alexb7396/picoCMP/Kicad picoCMP/BOM.xlsx

Reference | Value | Qty | Manufacturer_Part_Number | Footprint | Placed (YES/NO)
C1 | 22uF | 1 | EMK325B7226KMHP | Capacitor_SMD:C_1210_3225Metric_Pad1.33x2.70mm_HandSolder | YES
C2 | 22uF | 1 | TMK325B7226KM8P | Capacitor_SMD:C_1210_3225Metric_Pad1.33x2.70mm_HandSolder | YES
C14, C15 | 22uF | 2 | C2012X5R1C226K125AC | Capacitor_SMD:C_0805_2012Metric_Pad1.18x1.45mm_HandSolder | YES
C3,C11 | 1uF | 2 | UMK107ABJ105KA8T | Capacitor_SMD:C_0603_1608Metric_Pad1.08x0.95mm_HandSolder | YES
C5 | 1uF | 1 | C1206J105K5RACAUTO | Capacitor_SMD:C_1206_3216Metric_Pad1.33x1.80mm_HandSolder | YES
C10,C13 | 1uF | 2 | C0603X105J4RACTU |  | YES
C6,C16 | 47uF | 2 | C0805C476M9PACTU | Capacitor_SMD:C_0805_2012Metric_Pad1.18x1.45mm_HandSolder | YES
C7 | 56pF | 1 | 06035U560FAT2A | Capacitor_SMD:C_0603_1608Metric_Pad1.08x0.95mm_HandSolder | YES
C8,C17,C18,C19,C20,C21,C22,C24,C25,C26,C27,C28,C29,C30,C31,C32,C33,C34,C35,C36,C37,C38,C39,C40,C41,C42,C43,C44,C45,C46,C47,C48,C49,C50,C51,C52,C53,C54,C55,C56,C57,C58,C59,C60,C61,C62,C63,C64,C65,C66,C67,C68,C69,C70,C71,C72,C73,C74,C75,C76,C77,C78,C79 | 100nF | 63 | C0603C104J4RACTU | Capacitor_SMD:C_0603_1608Metric_Pad1.08x0.95mm_HandSolder | YES
C9 | 2.2nF | 1 | C0603C222F5GACAUTO | Capacitor_SMD:C_0603_1608Metric_Pad1.08x0.95mm_HandSolder | YES
C23 | 470nF | 1 | C0603X474J4RACTU | Capacitor_SMD:C_0603_1608Metric_Pad1.08x0.95mm_HandSolder | YES
C80 | 10uF | 1 | C1608X5R0J106K080AE | Capacitor_SMD:C_0603_1608Metric_Pad1.08x0.95mm_HandSolder | YES
C4,C12 | 1n | 2 | GCM1885C1H102FA16D | Capacitor_SMD:C_0603_1608Metric_Pad1.08x0.95mm_HandSolder | YES
L1 | 3.3uL | 1 | MSD7342-332MLC | SamacSys_Parts:MSD7342332MLC | YES
L2 | 22uL | 1 | MLF1608C220KTA00 | Inductor_SMD:L_0603_1608Metric_Pad1.05x0.95mm_HandSolder | YES
R1,R2 | 4.7K | 2 | CRT0603-FX-4701ELF | Resistor_SMD:R_0603_1608Metric_Pad0.98x0.95mm_HandSolder | YES
R3 | 25.5K | 1 | RT0603FRE0725K5L | Resistor_SMD:R_0603_1608Metric_Pad0.98x0.95mm_HandSolder | YES
R4 | 60.4K | 1 | RT0603FRE0760K4L | Resistor_SMD:R_0603_1608Metric_Pad0.98x0.95mm_HandSolder | YES
R5 | 100K | 1 | MCT06030C1003FP500 | Resistor_SMD:R_0603_1608Metric_Pad0.98x0.95mm_HandSolder | YES
R6 | 45.3K | 1 | RT0603FRE0745K3L | Resistor_SMD:R_0603_1608Metric_Pad0.98x0.95mm_HandSolder | YES
R7 | 124K | 1 | RT0603FRE07124KL | Resistor_SMD:R_0603_1608Metric_Pad0.98x0.95mm_HandSolder | YES
R8 | 6.19K | 1 | RT0603FRE076K19L | Resistor_SMD:R_0603_1608Metric_Pad0.98x0.95mm_HandSolder | YES
R9 | 40.2K | 1 | RT0603FRE0740K2L | Resistor_SMD:R_0603_1608Metric_Pad0.98x0.95mm_HandSolder | YES
R10 | 8.66K | 1 | RT0603FRE078K66L | Resistor_SMD:R_0603_1608Metric_Pad0.98x0.95mm_HandSolder | YES
R11 | 3.3K | 1 | RT0603FRE073K3L | Resistor_SMD:R_0603_1608Metric_Pad0.98x0.95mm_HandSolder | YES
R12 | 118K | 1 | RT0603FRE07118KL | Resistor_SMD:R_0603_1608Metric_Pad0.98x0.95mm_HandSolder | YES
R13 | 46.4K | 1 | RT0603FRE0746K4L | Resistor_SMD:R_0603_1608Metric_Pad0.98x0.95mm_HandSolder | YES
R14 | 210K | 1 | RT0603FRE07210KL | Resistor_SMD:R_0603_1608Metric_Pad0.98x0.95mm_HandSolder | YES
R15,R16,R19,R20,R22,R24,R31,R32,R33,R35,R39,R40,R41,R42,R43,R44,R48,R51,R55,R56,R57,R58,R59,R60,R64,R67,R71,R72,R73,R74,R75,R76,R80,R83,R87,R88,R89,R90,R91,R92,R96,R99,R103,R104,R105,R106,R107,R108,R112,R115,R119,R120,R121,R122,R123,R124,R128,R131,R135,R136,R137,R138,R139,R140,R144 | 50 | 65 | ERJ-3RED49R9V | Resistor_SMD:R_0603_1608Metric_Pad0.98x0.95mm_HandSolder | YES
R17 | 3K | 1 | 560112116128 | Resistor_SMD:R_0603_1608Metric_Pad0.98x0.95mm_HandSolder | YES
R18 | 1K | 1 | 560112116014 | Resistor_SMD:R_0603_1608Metric_Pad0.98x0.95mm_HandSolder | YES
R21,R23,R29,R30,R34,R38,R45,R49,R50,R54,R61,R65,R66,R70,R77,R81,R82,R86,R93,R97,R98,R102,R109,R113,R114,R118,R125,R129,R130,R134,R141,R145 | 4.4K | 32 | CRCW06034K42FKTA | Resistor_SMD:R_0603_1608Metric_Pad0.98x0.95mm_HandSolder | YES
R25,R26,R27,R28,R36,R37,R46,R47,R52,R53,R62,R63,R68,R69,R78,R79,R84,R85,R94,R95,R100,R101,R110,R111,R116,R117,R126,R127,R132,R133,R142,R143 | 10K | 32 | RC0603FR-1010KL | Resistor_SMD:R_0603_1608Metric_Pad0.98x0.95mm_HandSolder | YES
U1 | LTC2627IDE-1_PBF | 1 | LTC2627IDE-1#PBF | LTC2627:DFN-12_DE | YES
U2,U3,U6,U8,U10,U12,U14,U16,U18 | AD8657 | 9 | AD8657ARMZ | SamacSys_Parts:SOP65P490X110-8N | YES
U4,U5,U7,U9,U11,U13,U15,U17 | LMH7322 | 8 | LMH7322SQ/NOPB | SamacSys_Parts:QFN50P400X400X80-25N | YES
IC6 | AD5673RBCPZ-1 | 1 | AD5673RBCPZ-1 | SamacSys_Parts:QFN40P400X400X100-29N-D | YES
IC5 | LT1963AES8-3.3#TRPBF | 1 | LT1963AES8-3.3#TRPBF | SamacSys_Parts:SOIC127P599X175-8N | YES
IC4 | LT3015IMSE-15#PBF | 1 | LT3015IMSE-15#PBF | SamacSys_Parts:SOP65P490X110-13N | YES
IC1,IC3 | LTM8074EY#PBF | 2 | LTM8074EY#PBF | SamacSys_Parts:BGA25C65P5X5_400X400X198 | YES
IC2 | LT3581IDE#PBF | 1 | LT3581IDE#PBF | SamacSys_Parts:SON50P300X400X80-15N-D | YES
J2 | 9185346323 | 1 | 9185346323 | SamacSys_Parts:09185346323 | YES
J4 | 9195346829 | 1 | 9195346829 | Connector:2x17 Connector | YES
J3 | EPL.00.250.NTN | 1 | EPL.00.250.DTN | LEMO-EPA.00.250.DTN:LEMO-EPA.00.250.DTN | YES
J1,J6 | 5-1775444-3 | 2 | 5-1775444-3 | SamacSys_Parts:517754443 | YES
J5 | 1473770000 | 1 | 2383942-2 | SamacSys_Parts:1473770000 | YES
D1 | SSB44-M3_5BT | 1 | SSB44-M3/5BT | SamacSys_Parts:DIOM5436X244N | YES
I2C soscket |  | 1 | 1775441-3 |  | NO
