alexb7396/picoCMP/Kicad picoCMP/A5256.kicad_sch

## KiCad design Kicad picoCMP/A5256.kicad_sch (2025-03-20)

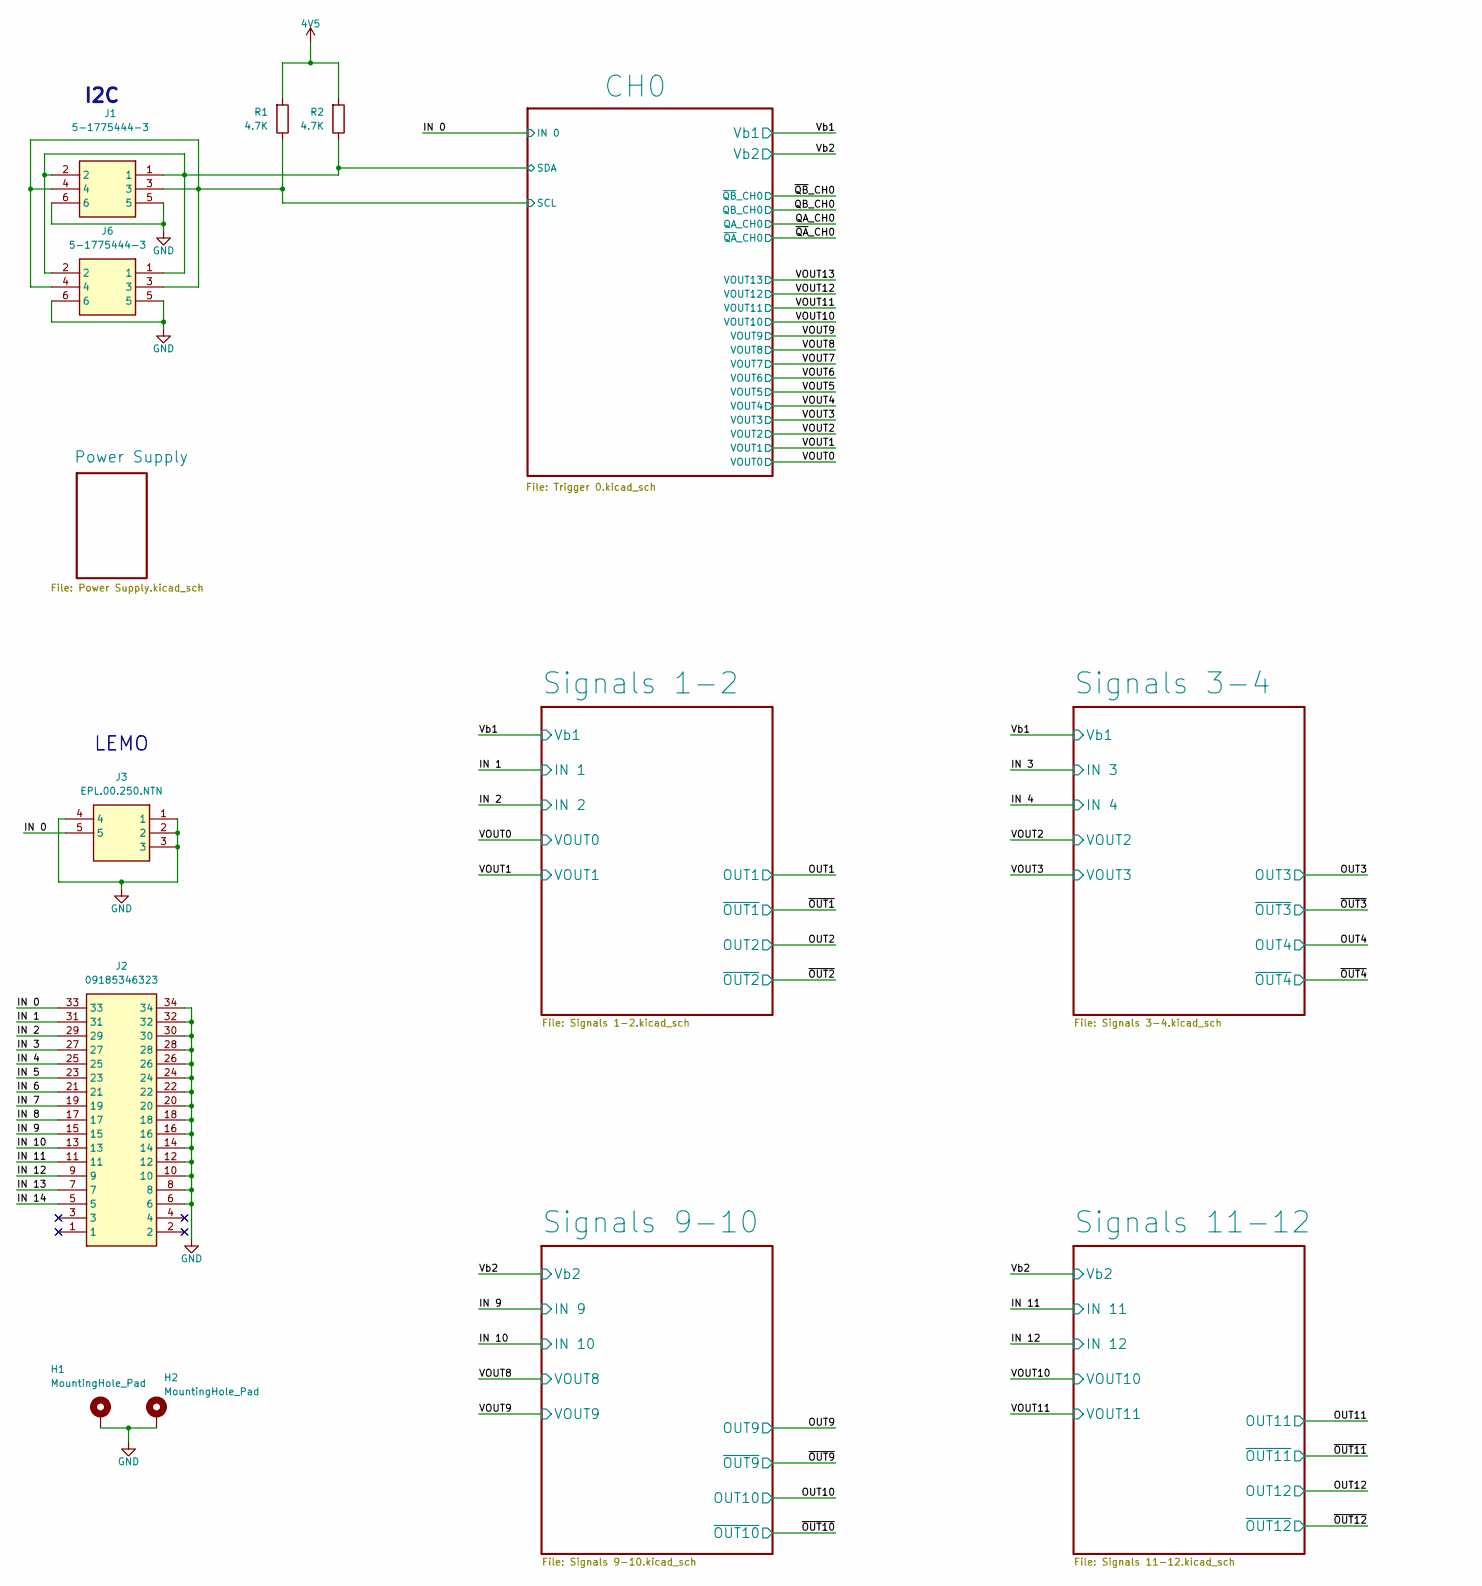
[picture p1: schematic A5256.kicad_sch, part in row 1, column 1]

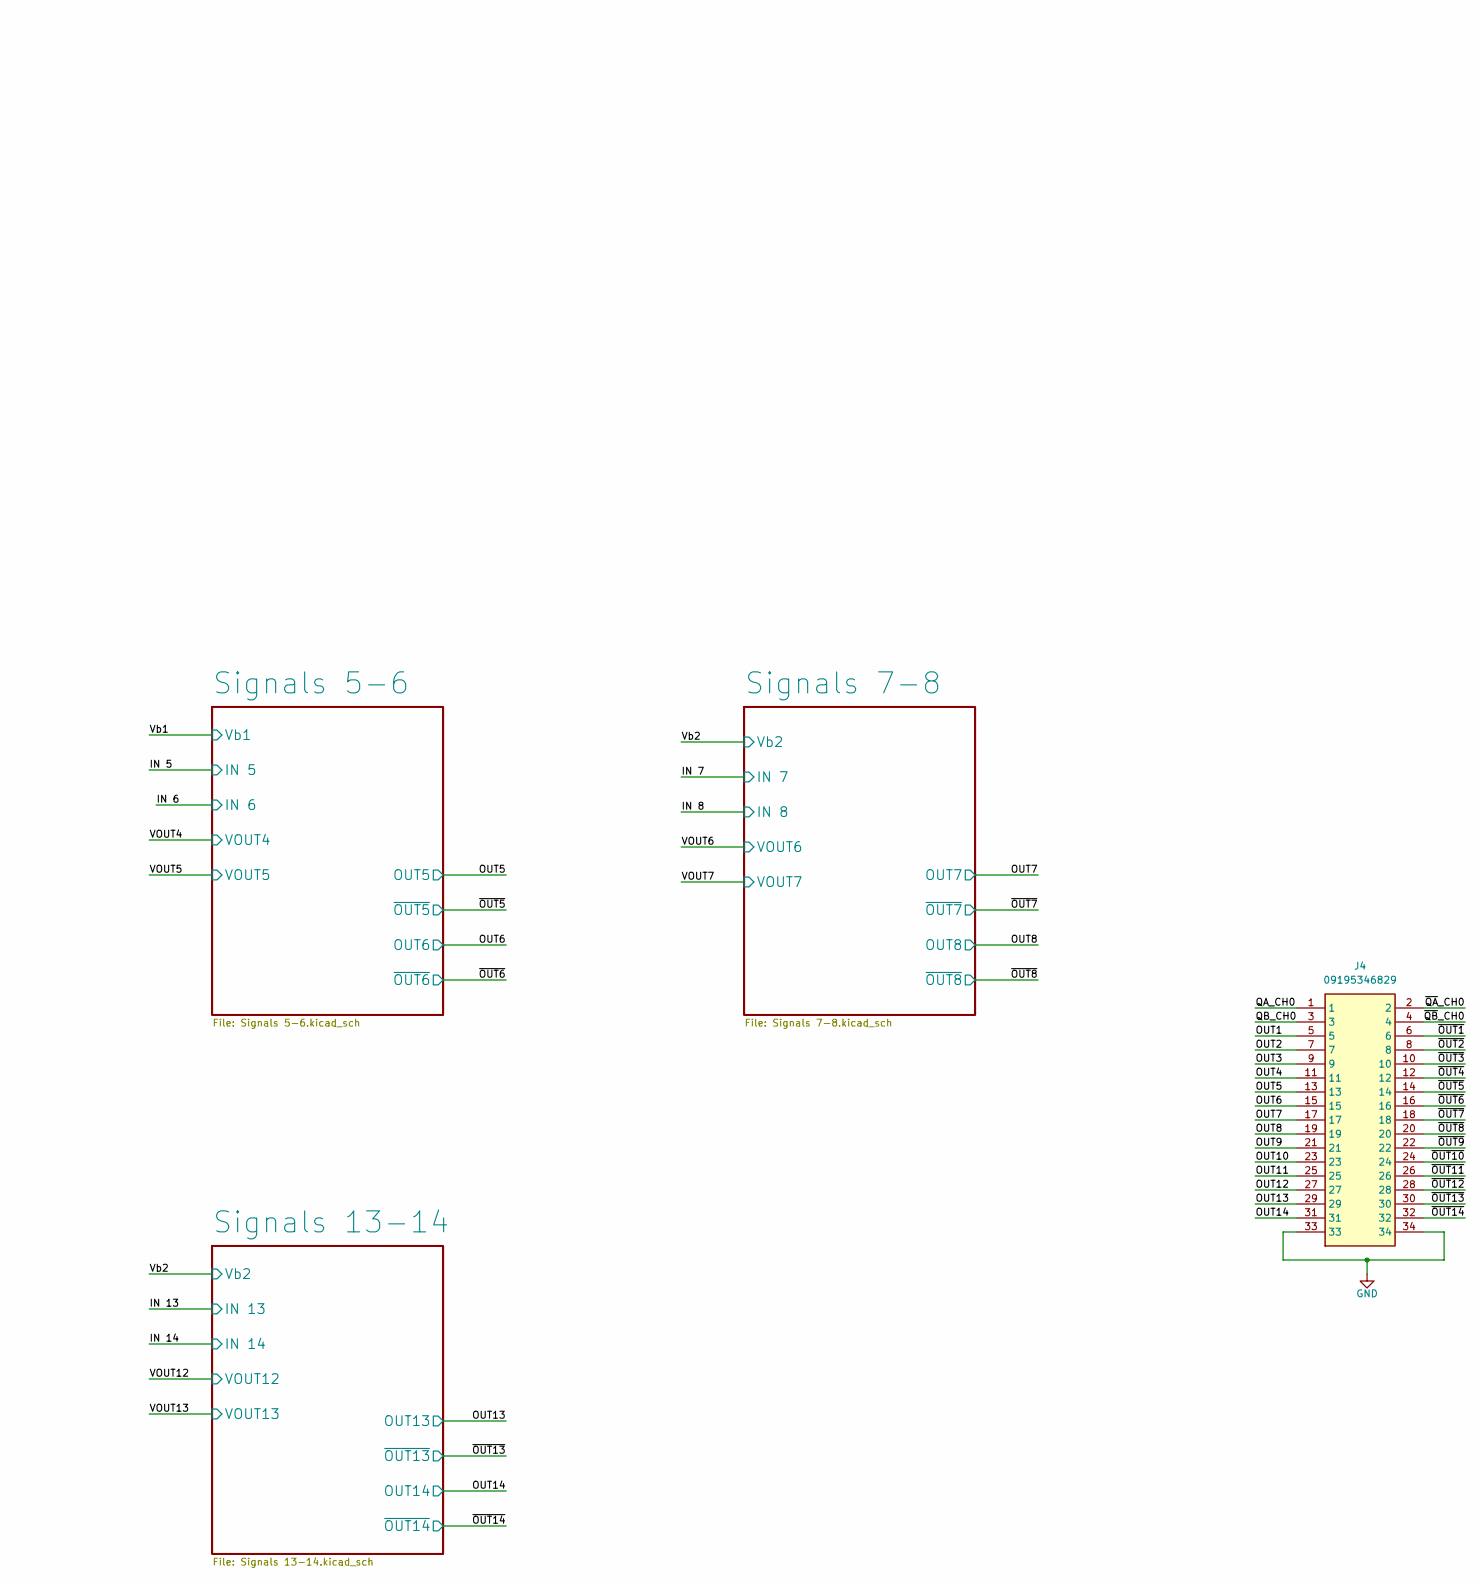
[picture p2: schematic A5256.kicad_sch, part in row 1, column 2]

Parts:
H1, H2: MountingHole_Pad; MountingHole_3mm_Pad_TopBottom
J1, J6: 5-1775444-3; 517754443; Mouser Part Number 571-5-1775444-3
J2: 09185346323; Mouser Part Number 617-09-18-534-6323
J3: EPL.00.250.NTN; LEMO-EPA.00.250.DTN; Mouser Part Number 736-EPL00250NTN
J4: 09195346829; 2x17 Connector; Mouser Part Number 617-09195346829
R1, R2: 4.7K; R_0603_1608Metric_Pad0.98x0.95mm_HandSolder

Connections:
4V5: R1.2, R2.2
GND: H1.1, H2.1, J1.5, J1.6, J2.6, J2.8, J2.10, J2.12, J2.14, J2.16, J2.18, J2.20, J2.22, J2.24, J2.26, J2.28, J2.30, J2.32, J2.34, J3.1, J3.2, J3.3, J3.4, J4.33, J4.34, J6.5, J6.6
IN 0: J2.33, J3.5
IN 1: J2.31
IN 2: J2.29
IN 3: J2.27
IN 4: J2.25
IN 5: J2.23
IN 6: J2.21
IN 7: J2.19
IN 8: J2.17
IN 9: J2.15
IN 10: J2.13
IN 11: J2.11
IN 12: J2.9
IN 13: J2.7
IN 14: J2.5
OUT1: J4.5
OUT2: J4.7
OUT3: J4.9
OUT4: J4.11
OUT5: J4.13
OUT6: J4.15
OUT7: J4.17
OUT8: J4.19
OUT9: J4.21
OUT10: J4.23
OUT11: J4.25
OUT12: J4.27
OUT13: J4.29
OUT14: J4.31
QA_CH0: J4.1
QB_CH0: J4.3
SCL: J1.3, J1.4, J6.3, J6.4, R1.1
SDA: J1.1, J1.2, J6.1, J6.2, R2.1
~OUT1: J4.6
~OUT2: J4.8
~OUT3: J4.10
~OUT4: J4.12
~OUT5: J4.14
~OUT6: J4.16
~OUT7: J4.18
~OUT8: J4.20
~OUT9: J4.22
~OUT10: J4.24
~OUT11: J4.26
~OUT12: J4.28
~OUT13: J4.30
~OUT14: J4.32
~QA_CH0: J4.2
~QB_CH0: J4.4

Notes on the sheet:
I2C
LEMO
