alexb7396/picoCMP/Kicad picoCMP/Power Supply.kicad_sch

## KiCad design Kicad picoCMP/Power Supply.kicad_sch (2025-03-20)

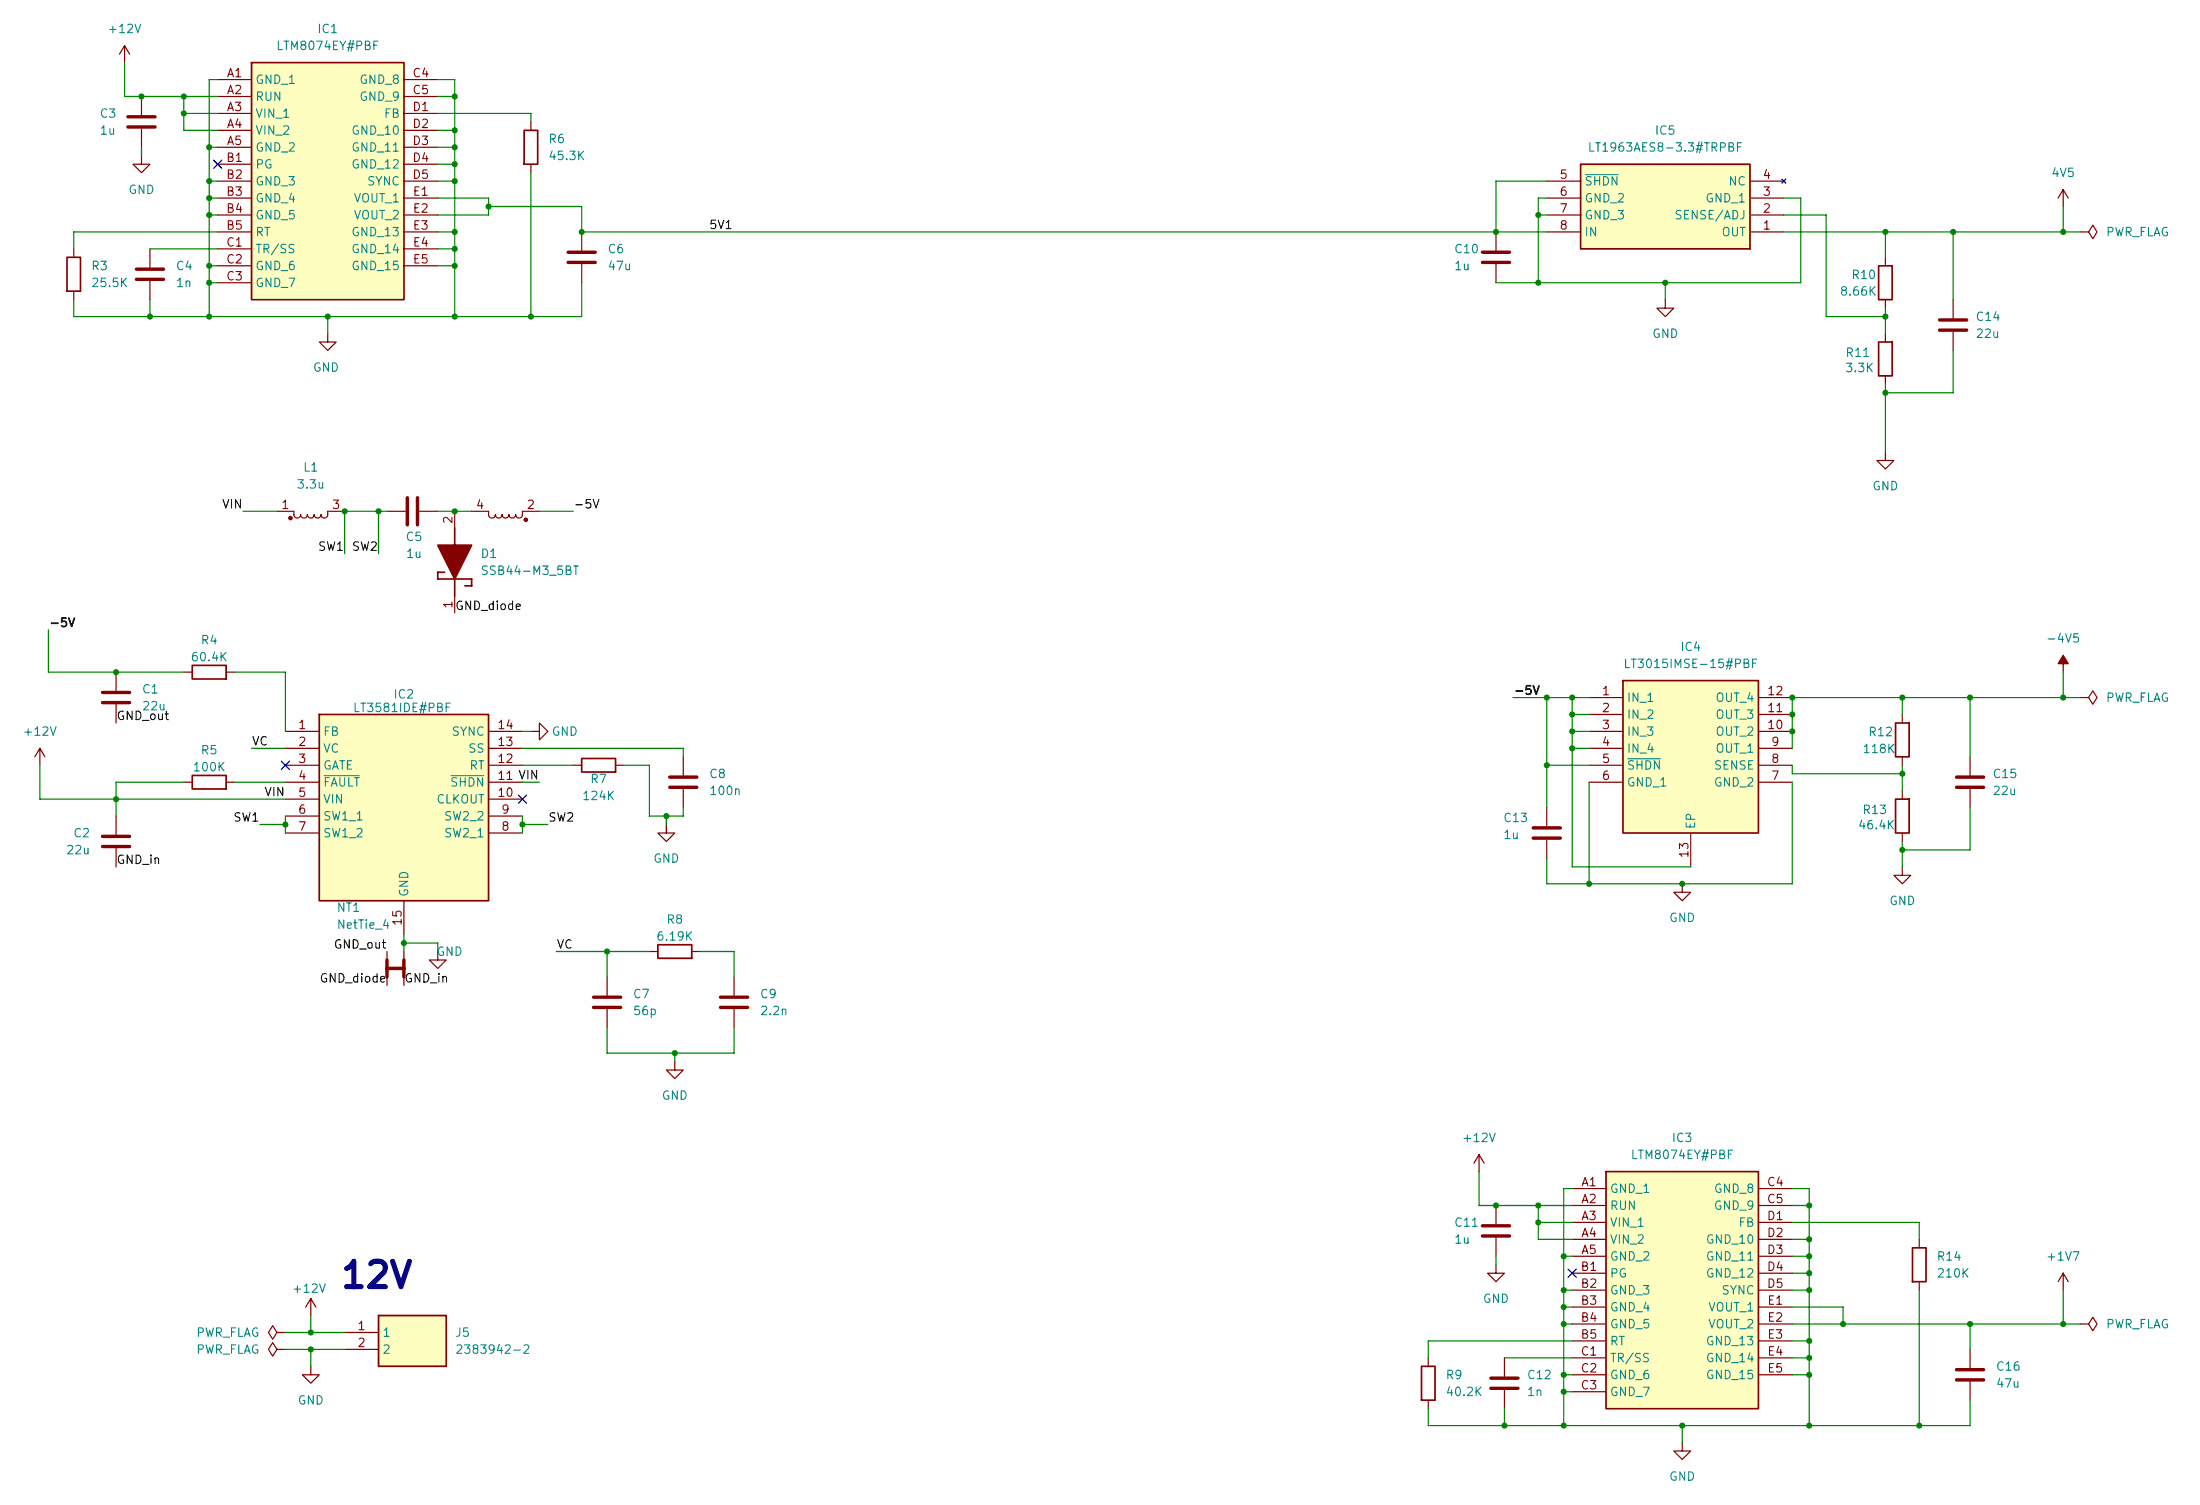
[picture p3: schematic Power Supply.kicad_sch]

Parts:
C1, C2: 22u; C_1210_3225Metric_Pad1.33x2.70mm_HandSolder
C3, C10, C11, C13: 1u; C_0603_1608Metric_Pad1.08x0.95mm_HandSolder
C4, C12: 1n; C_0603_1608Metric_Pad1.08x0.95mm_HandSolder
C5: 1u; C_1206_3216Metric_Pad1.33x1.80mm_HandSolder
C6, C16: 47u; C_0805_2012Metric_Pad1.18x1.45mm_HandSolder
C7: 56p; C_0603_1608Metric_Pad1.08x0.95mm_HandSolder
C8: 100n; C_0603_1608Metric_Pad1.08x0.95mm_HandSolder
C9: 2.2n; C_0603_1608Metric_Pad1.08x0.95mm_HandSolder
C14, C15: 22u; C_0805_2012Metric_Pad1.18x1.45mm_HandSolder
D1: SSB44-M3_5BT; DIOM5436X244N; Mouser Part Number 78-SSB44-M35BT
IC1, IC3: LTM8074EY#PBF; BGA25C65P5X5_400X400X198; Manufacturer_Part_Number LTM8074EY#PBF; Mouser Part Number 584-LTM8074EY#PBF
IC2: LT3581IDE#PBF; SON50P300X400X80-15N-D; Mouser Part Number 584-LT3581IDE#PBF
IC4: LT3015IMSE-15#PBF; SOP65P490X110-13N; Manufacturer_Part_Number LT3015IMSE-15#PBF; Mouser Part Number 584-LT3015IMSE-15PBF
IC5: LT1963AES8-3.3#TRPBF; SOIC127P599X175-8N; Manufacturer_Part_Number LT1963AES8-3.3#TRPBF; Mouser Part Number 584-1963AES8-3.3TPF
J5: 2383942-2; 23839422; Mouser Part Number 571-2383942-2
L1: 3.3u; MSD7342332MLC
NT1: NetTie_4; NetTie-4_SMD_Pad0.5mm
R3: 25.5K; R_0603_1608Metric_Pad0.98x0.95mm_HandSolder
R4: 60.4K; R_0603_1608Metric_Pad0.98x0.95mm_HandSolder
R5: 100K; R_0603_1608Metric_Pad0.98x0.95mm_HandSolder
R6: 45.3K; R_0603_1608Metric_Pad0.98x0.95mm_HandSolder
R7: 124K; R_0603_1608Metric_Pad0.98x0.95mm_HandSolder
R8: 6.19K; R_0603_1608Metric_Pad0.98x0.95mm_HandSolder
R9: 40.2K; R_0603_1608Metric_Pad0.98x0.95mm_HandSolder
R10: 8.66K; R_0603_1608Metric_Pad0.98x0.95mm_HandSolder
R11: 3.3K; R_0603_1608Metric_Pad0.98x0.95mm_HandSolder
R12: 118K; R_0603_1608Metric_Pad0.98x0.95mm_HandSolder
R13: 46.4K; R_0603_1608Metric_Pad0.98x0.95mm_HandSolder
R14: 210K; R_0603_1608Metric_Pad0.98x0.95mm_HandSolder

Connections:
4V5: C14.1, IC5.1 (OUT), R10.2
5V1: C6.1, C10.1, IC1.E1 (VOUT_1), IC1.E2 (VOUT_2), IC5.5 (~SHDN), IC5.8 (IN)
+1V7: C16.1, IC3.E1 (VOUT_1), IC3.E2 (VOUT_2)
+12V: C2.1, C3.1, C11.1, IC1.A2 (RUN), IC1.A3 (VIN_1), IC1.A4 (VIN_2), IC2.5 (VIN), IC2.11 (~SHDN), IC3.A2 (RUN), IC3.A3 (VIN_1), IC3.A4 (VIN_2), J5.1, L1.1, R5.1
-4V5: C15.1, IC4.9 (OUT_1), IC4.10 (OUT_2), IC4.11 (OUT_3), IC4.12 (OUT_4), R12.2
-5V: C1.1, C13.1, IC4.1 (IN_1), IC4.2 (IN_2), IC4.3 (IN_3), IC4.4 (IN_4), IC4.5 (~SHDN), IC4.13 (EP), L1.2, R4.1
GND: C3.2, C4.2, C6.2, C7.1, C8.2, C9.2, C10.2, C11.2, C12.2, C13.2, C14.2, C15.2, C16.2, IC1.A1 (GND_1), IC1.A5 (GND_2), IC1.B2 (GND_3), IC1.B3 (GND_4), IC1.B4 (GND_5), IC1.C2 (GND_6), IC1.C3 (GND_7), IC1.C4 (GND_8), IC1.C5 (GND_9), IC1.D2 (GND_10), IC1.D3 (GND_11), IC1.D4 (GND_12), IC1.D5 (SYNC), IC1.E3 (GND_13), IC1.E4 (GND_14), IC1.E5 (GND_15), IC2.14 (SYNC), IC2.15 (GND), IC3.A1 (GND_1), IC3.A5 (GND_2), IC3.B2 (GND_3), IC3.B3 (GND_4), IC3.B4 (GND_5), IC3.C2 (GND_6), IC3.C3 (GND_7), IC3.C4 (GND_8), IC3.C5 (GND_9), IC3.D2 (GND_10), IC3.D3 (GND_11), IC3.D4 (GND_12), IC3.D5 (SYNC), IC3.E3 (GND_13), IC3.E4 (GND_14), IC3.E5 (GND_15), IC4.6 (GND_1), IC4.7 (GND_2), IC5.3 (GND_1), IC5.6 (GND_2), IC5.7 (GND_3), J5.2, NT1.4, R3.2, R6.2, R7.2, R9.2, R11.1, R13.1, R14.2
GND_diode: D1.1 (K), NT1.1
GND_in: C2.2, NT1.3
GND_out: C1.2, NT1.2
unnamed: C4.1, IC1.C1 (TR/SS)
unnamed: C5.1, D1.2 (A), L1.4
unnamed: C8.1, IC2.13 (SS)
unnamed: C9.1, R8.2
unnamed: C12.1, IC3.C1 (TR/SS)
unnamed: IC1.B5 (RT), R3.1
unnamed: IC1.D1 (FB), R6.1
unnamed: IC2.1 (FB), R4.2
unnamed: IC2.4 (~FAULT), R5.2
unnamed: IC2.12 (RT), R7.1
unnamed: IC3.B5 (RT), R9.1
unnamed: IC3.D1 (FB), R14.1
unnamed: IC4.8 (SENSE), R12.1, R13.2
unnamed: IC5.2 (SENSE/ADJ), R10.1, R11.2
SW1: C5.2, IC2.6 (SW1_1), IC2.7 (SW1_2), IC2.8 (SW2_1), IC2.9 (SW2_2), L1.3
VC: C7.2, IC2.2 (VC), R8.1

Notes on the sheet:
12V
