alexb7396/picoCMP/Kicad picoCMP/Signal Inputs.kicad_sch

## KiCad design Kicad picoCMP/Signal Inputs.kicad_sch (2025-03-20)

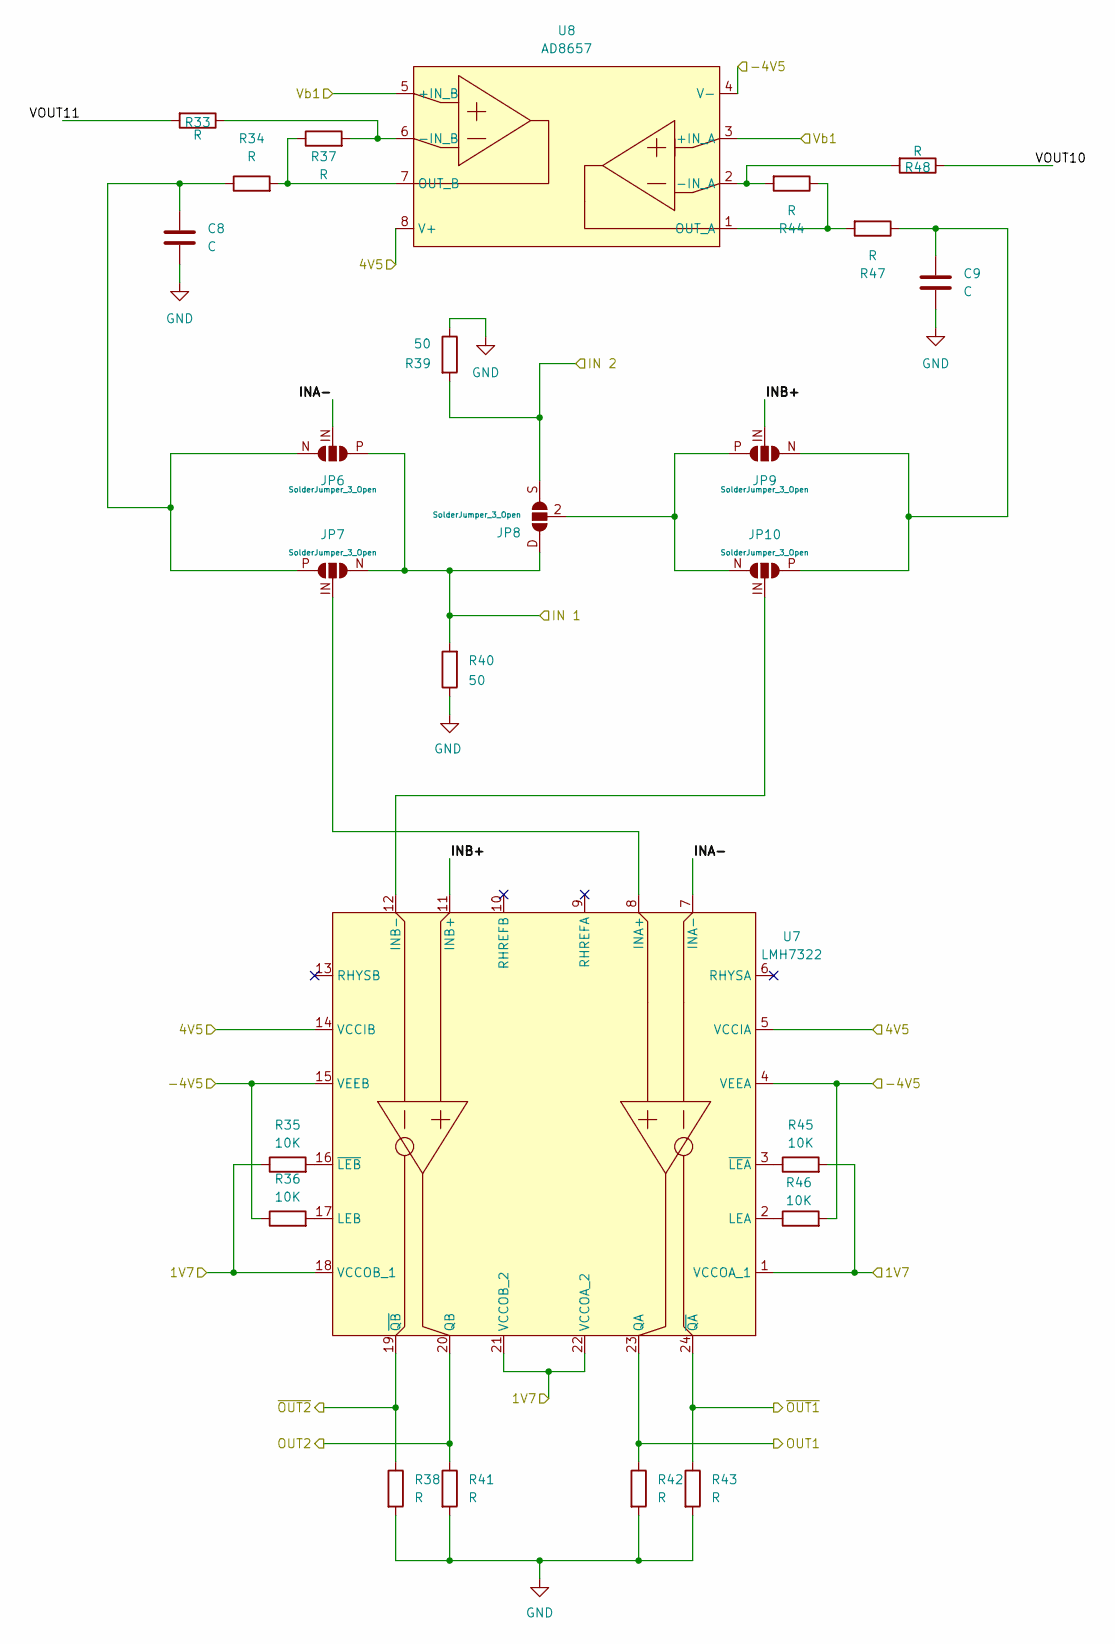
[picture p4: schematic Signal Inputs.kicad_sch]

Parts:
C8, C9: C
JP6, JP7, JP8, JP9, JP10: SolderJumper_3_Open
R33, R34, R37, R38, R41, R42, R43, R44, R47, R48: R
R35, R36, R45, R46: 10K
R39, R40: 50
U7: LMH7322
U8: AD8657; SOP65P490X110-8N

Connections:
1V7: R35.1, R45.2, U7.1 (VCCOA_1), U7.18 (VCCOB_1), U7.21 (VCCOB_2), U7.22 (VCCOA_2)
4V5: U7.5 (VCCIA), U7.14 (VCCIB), U8.8 (V+)
-4V5: R36.1, R46.2, U7.4 (VEEA), U7.15 (VEEB), U8.4 (V-)
GND: C8.2, C9.2, R38.2, R39.1, R40.1, R41.2, R42.2, R43.2
IN 1: JP6.P (A), JP7.N (B), JP8.D (A), R40.2
IN 2: JP8.S (B), R39.2
INA-: JP6.IN (C), U7.7 (INA-)
INB+: JP9.IN (C), U7.11 (INB+)
unnamed: C8.1, JP6.N (B), JP7.P (A), R34.1
unnamed: C9.1, JP9.N (A), JP10.P (B), R47.1
unnamed: JP7.IN (C), U7.8 (INA+)
unnamed: JP10.IN (C), U7.12 (INB-)
unnamed: JP8.2 (IN), JP9.P (B), JP10.N (A)
unnamed: R33.1, R37.2, U8.6 (-IN_B)
unnamed: R34.2, R37.1, U8.7 (OUT_B)
unnamed: R35.2, U7.16 (~LEB)
unnamed: R36.2, U7.17 (LEB)
unnamed: R44.1, R47.2, U8.1 (OUT_A)
unnamed: R44.2, R48.2, U8.2 (-IN_A)
unnamed: R45.1, U7.3 (~LEA)
unnamed: R46.1, U7.2 (LEA)
OUT1: R42.1, U7.23 (QA)
OUT2: R41.1, U7.20 (QB)
VOUT10: R48.1
VOUT11: R33.2
Vb1: U8.3 (+IN_A), U8.5 (+IN_B)
~OUT1: R43.1, U7.24 (~QA)
~OUT2: R38.1, U7.19 (~QB)
