alexb7396/picoCMP/Kicad picoCMP/Signals 1-2.kicad_sch

## KiCad design Kicad picoCMP/Signals 1-2.kicad_sch (2025-03-20)

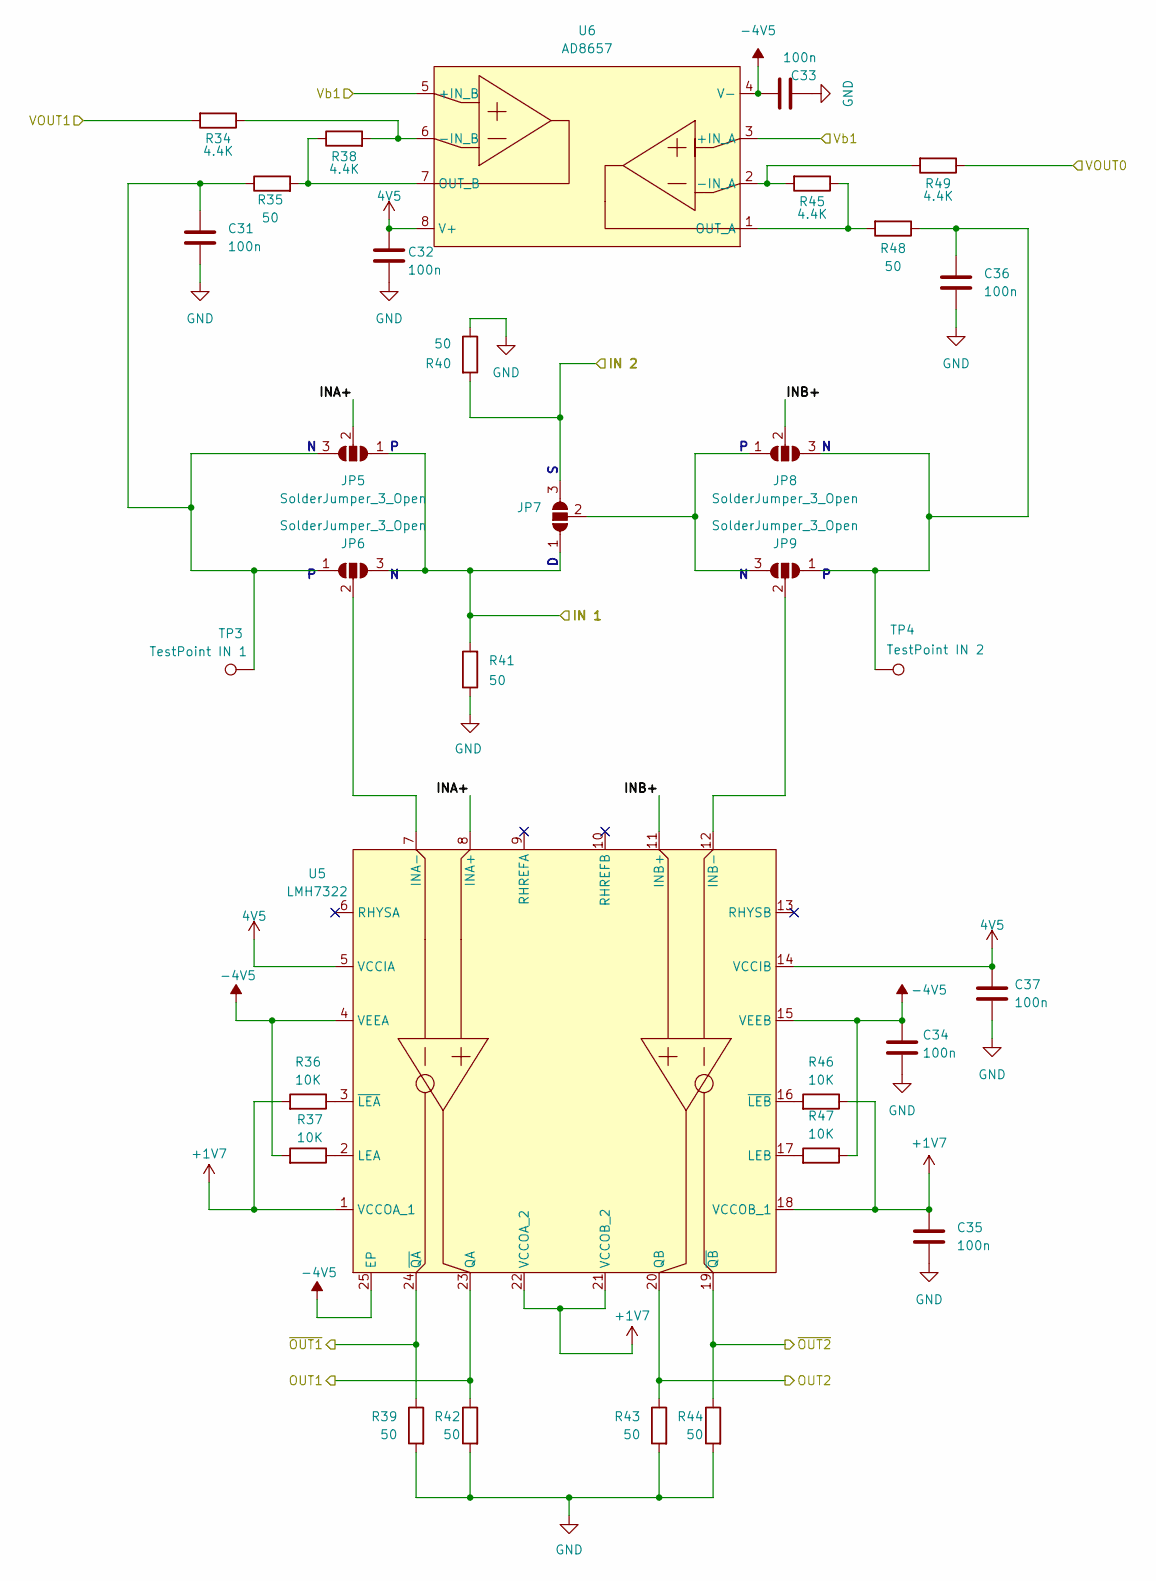
[picture p5: schematic Signals 1-2.kicad_sch]

Parts:
C31, C32, C33, C34, C35, C36, C37: 100n; C_0603_1608Metric_Pad1.08x0.95mm_HandSolder
JP5, JP6, JP7, JP8, JP9: SolderJumper_3_Open; SolderJumper-3_P1.3mm_Open_RoundedPad1.0x1.5mm_NumberLabels
R34, R38, R45, R49: 4.4K; R_0603_1608Metric_Pad0.98x0.95mm_HandSolder
R35, R39, R40, R41, R42, R43, R44, R48: 50; R_0603_1608Metric_Pad0.98x0.95mm_HandSolder
R36, R37, R46, R47: 10K; R_0603_1608Metric_Pad0.98x0.95mm_HandSolder
TP3: TestPoint IN 1; TestPoint_Pad_D1.0mm
TP4: TestPoint IN 2; TestPoint_Pad_D1.0mm
U5: LMH7322; QFN50P400X400X80-25N
U6: AD8657; SOP65P490X110-8N

Connections:
4V5: C32.1, C37.1, U5.5 (VCCIA), U5.14 (VCCIB), U6.8 (V+)
+1V7: C35.1, R36.2, R46.1, U5.1 (VCCOA_1), U5.18 (VCCOB_1), U5.21 (VCCOB_2), U5.22 (VCCOA_2)
-4V5: C33.1, C34.1, R37.2, R47.1, U5.4 (VEEA), U5.15 (VEEB), U5.25 (EP), U6.4 (V-)
GND: C31.2, C32.2, C33.2, C34.2, C35.2, C36.2, C37.2, R39.2, R40.1, R41.1, R42.2, R43.2, R44.2
IN 1: JP5.1 (A), JP6.3 (B), JP7.1 (A), R41.2
IN 2: JP7.3 (B), R40.2
INA+: JP5.2 (C), U5.8 (INA+)
INB+: JP8.2 (C), U5.11 (INB+)
unnamed: C31.1, JP5.3 (B), JP6.1 (A), R35.1, TP3.1
unnamed: C36.1, JP8.3 (B), JP9.1 (A), R48.1, TP4.1
unnamed: JP6.2 (C), U5.7 (INA-)
unnamed: JP7.2 (C), JP8.1 (A), JP9.3 (B)
unnamed: JP9.2 (C), U5.12 (INB-)
unnamed: R34.1, R38.2, U6.6 (-IN_B)
unnamed: R35.2, R38.1, U6.7 (OUT_B)
unnamed: R36.1, U5.3 (~LEA)
unnamed: R37.1, U5.2 (LEA)
unnamed: R45.1, R48.2, U6.1 (OUT_A)
unnamed: R45.2, R49.2, U6.2 (-IN_A)
unnamed: R46.2, U5.16 (~LEB)
unnamed: R47.2, U5.17 (LEB)
OUT1: R42.1, U5.23 (QA)
OUT2: R43.1, U5.20 (QB)
VOUT0: R49.1
VOUT1: R34.2
Vb1: U6.3 (+IN_A), U6.5 (+IN_B)
~OUT1: R39.1, U5.24 (~QA)
~OUT2: R44.1, U5.19 (~QB)
