alexb7396/picoCMP/Kicad picoCMP/Signals 3-4.kicad_sch

## KiCad design Kicad picoCMP/Signals 3-4.kicad_sch (2025-03-20)

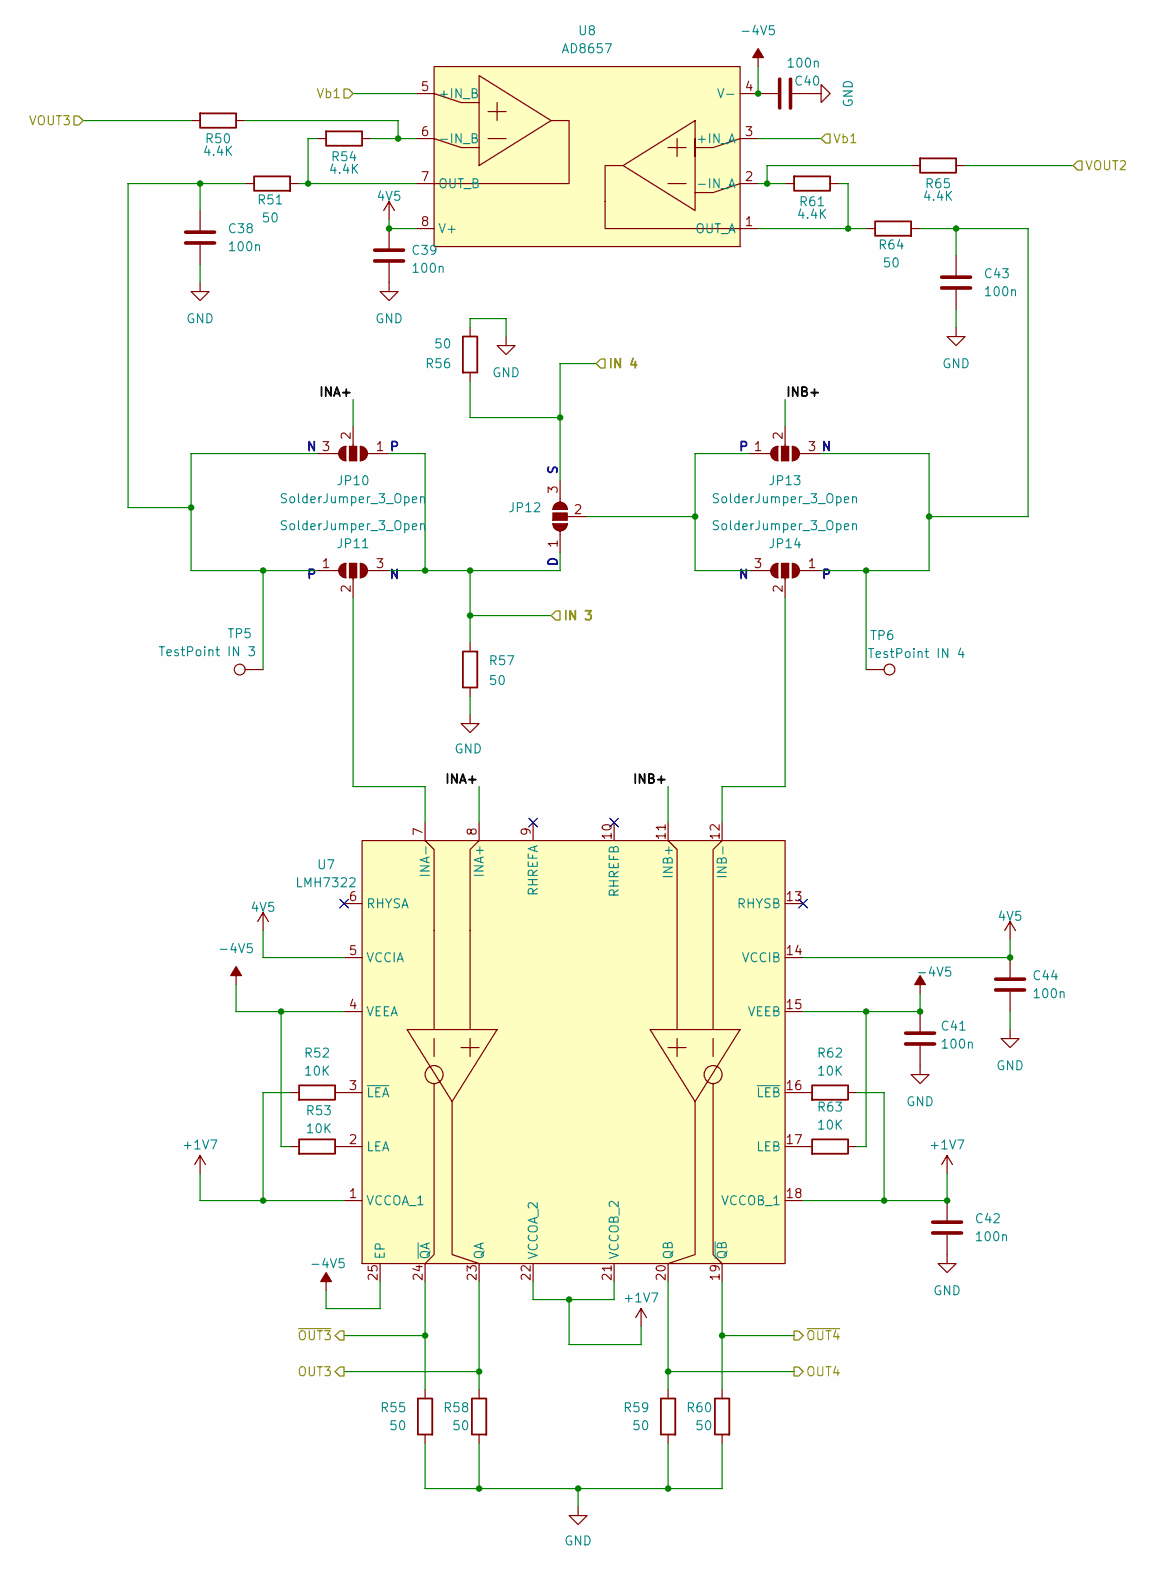
[picture p6: schematic Signals 3-4.kicad_sch]

Parts:
C38, C39, C40, C41, C42, C43, C44: 100n; C_0603_1608Metric_Pad1.08x0.95mm_HandSolder
JP10, JP11, JP12, JP13, JP14: SolderJumper_3_Open; SolderJumper-3_P1.3mm_Open_RoundedPad1.0x1.5mm_NumberLabels
R50, R54, R61, R65: 4.4K; R_0603_1608Metric_Pad0.98x0.95mm_HandSolder
R51, R55, R56, R57, R58, R59, R60, R64: 50; R_0603_1608Metric_Pad0.98x0.95mm_HandSolder
R52, R53, R62, R63: 10K; R_0603_1608Metric_Pad0.98x0.95mm_HandSolder
TP5: TestPoint IN 3; TestPoint_Pad_D1.0mm
TP6: TestPoint IN 4; TestPoint_Pad_D1.0mm
U7: LMH7322; QFN50P400X400X80-25N
U8: AD8657; SOP65P490X110-8N

Connections:
4V5: C39.1, C44.1, U7.5 (VCCIA), U7.14 (VCCIB), U8.8 (V+)
+1V7: C42.1, R52.2, R62.1, U7.1 (VCCOA_1), U7.18 (VCCOB_1), U7.21 (VCCOB_2), U7.22 (VCCOA_2)
-4V5: C40.1, C41.1, R53.2, R63.1, U7.4 (VEEA), U7.15 (VEEB), U7.25 (EP), U8.4 (V-)
GND: C38.2, C39.2, C40.2, C41.2, C42.2, C43.2, C44.2, R55.2, R56.1, R57.1, R58.2, R59.2, R60.2
IN 3: JP10.1 (A), JP11.3 (B), JP12.1 (A), R57.2
IN 4: JP12.3 (B), R56.2
INA+: JP10.2 (C), U7.8 (INA+)
INB+: JP13.2 (C), U7.11 (INB+)
unnamed: C38.1, JP10.3 (B), JP11.1 (A), R51.1, TP5.1
unnamed: C43.1, JP13.3 (B), JP14.1 (A), R64.2, TP6.1
unnamed: JP11.2 (C), U7.7 (INA-)
unnamed: JP12.2 (C), JP13.1 (A), JP14.3 (B)
unnamed: JP14.2 (C), U7.12 (INB-)
unnamed: R50.1, R54.1, U8.6 (-IN_B)
unnamed: R51.2, R54.2, U8.7 (OUT_B)
unnamed: R52.1, U7.3 (~LEA)
unnamed: R53.1, U7.2 (LEA)
unnamed: R61.1, R64.1, U8.1 (OUT_A)
unnamed: R61.2, R65.2, U8.2 (-IN_A)
unnamed: R62.2, U7.16 (~LEB)
unnamed: R63.2, U7.17 (LEB)
OUT3: R58.1, U7.23 (QA)
OUT4: R59.1, U7.20 (QB)
VOUT2: R65.1
VOUT3: R50.2
Vb1: U8.3 (+IN_A), U8.5 (+IN_B)
~OUT3: R55.1, U7.24 (~QA)
~OUT4: R60.1, U7.19 (~QB)
