alexb7396/picoCMP/Kicad picoCMP/Signals 5-6.kicad_sch

## KiCad design Kicad picoCMP/Signals 5-6.kicad_sch (2025-03-20)

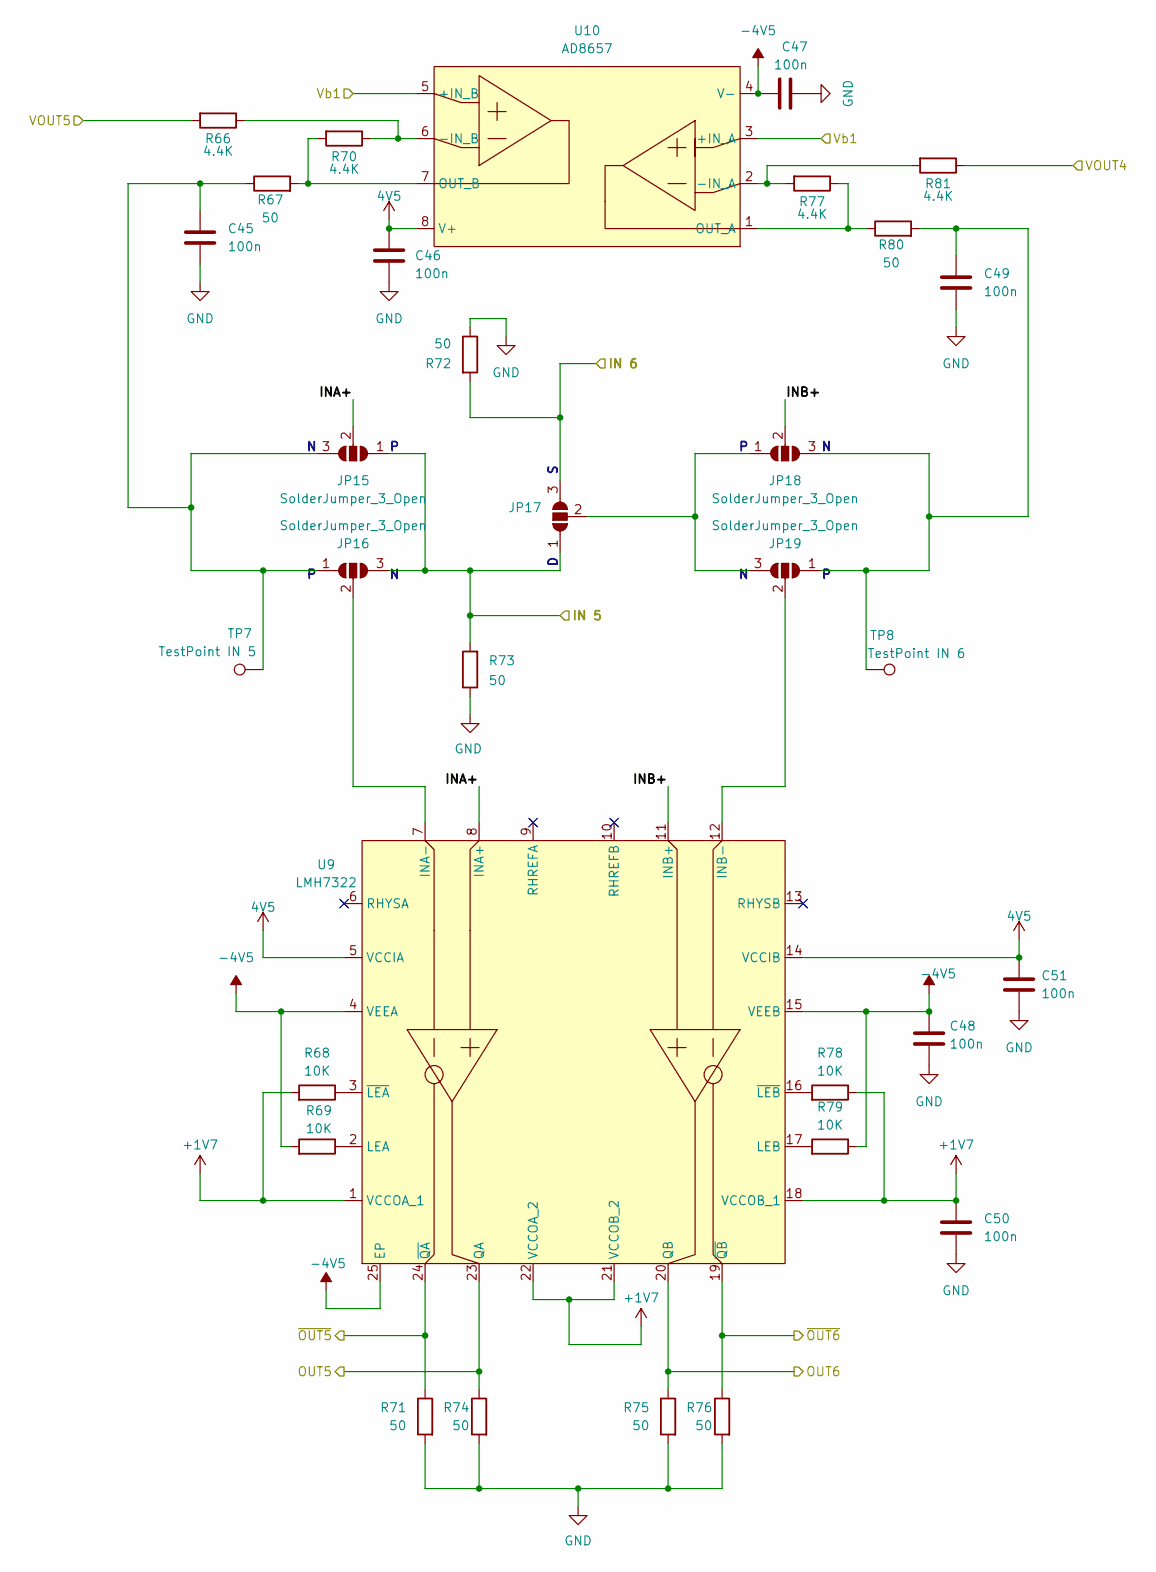
[picture p7: schematic Signals 5-6.kicad_sch]

Parts:
C45, C46, C47, C48, C49, C50, C51: 100n; C_0603_1608Metric_Pad1.08x0.95mm_HandSolder
JP15, JP16, JP17, JP18, JP19: SolderJumper_3_Open; SolderJumper-3_P1.3mm_Open_RoundedPad1.0x1.5mm_NumberLabels
R66, R70, R77, R81: 4.4K; R_0603_1608Metric_Pad0.98x0.95mm_HandSolder
R67, R71, R72, R73, R74, R75, R76, R80: 50; R_0603_1608Metric_Pad0.98x0.95mm_HandSolder
R68, R69, R78, R79: 10K; R_0603_1608Metric_Pad0.98x0.95mm_HandSolder
TP7: TestPoint IN 5; TestPoint_Pad_D1.0mm
TP8: TestPoint IN 6; TestPoint_Pad_D1.0mm
U9: LMH7322; QFN50P400X400X80-25N
U10: AD8657; SOP65P490X110-8N

Connections:
4V5: C46.1, C51.1, U9.5 (VCCIA), U9.14 (VCCIB), U10.8 (V+)
+1V7: C50.1, R68.2, R78.1, U9.1 (VCCOA_1), U9.18 (VCCOB_1), U9.21 (VCCOB_2), U9.22 (VCCOA_2)
-4V5: C47.1, C48.1, R69.2, R79.1, U9.4 (VEEA), U9.15 (VEEB), U9.25 (EP), U10.4 (V-)
GND: C45.2, C46.2, C47.2, C48.2, C49.2, C50.2, C51.2, R71.2, R72.1, R73.1, R74.2, R75.2, R76.2
IN 5: JP15.1 (A), JP16.3 (B), JP17.1 (A), R73.2
IN 6: JP17.3 (B), R72.2
INA+: JP15.2 (C), U9.8 (INA+)
INB+: JP18.2 (C), U9.11 (INB+)
unnamed: C45.1, JP15.3 (B), JP16.1 (A), R67.1, TP7.1
unnamed: C49.1, JP18.3 (B), JP19.1 (A), R80.2, TP8.1
unnamed: JP16.2 (C), U9.7 (INA-)
unnamed: JP17.2 (C), JP18.1 (A), JP19.3 (B)
unnamed: JP19.2 (C), U9.12 (INB-)
unnamed: R66.1, R70.1, U10.6 (-IN_B)
unnamed: R67.2, R70.2, U10.7 (OUT_B)
unnamed: R68.1, U9.3 (~LEA)
unnamed: R69.1, U9.2 (LEA)
unnamed: R77.1, R80.1, U10.1 (OUT_A)
unnamed: R77.2, R81.2, U10.2 (-IN_A)
unnamed: R78.2, U9.16 (~LEB)
unnamed: R79.2, U9.17 (LEB)
OUT5: R74.1, U9.23 (QA)
OUT6: R75.1, U9.20 (QB)
VOUT4: R81.1
VOUT5: R66.2
Vb1: U10.3 (+IN_A), U10.5 (+IN_B)
~OUT5: R71.1, U9.24 (~QA)
~OUT6: R76.1, U9.19 (~QB)
