alexb7396/picoCMP/Kicad picoCMP/Signals 7-8.kicad_sch

## KiCad design Kicad picoCMP/Signals 7-8.kicad_sch (2025-03-20)

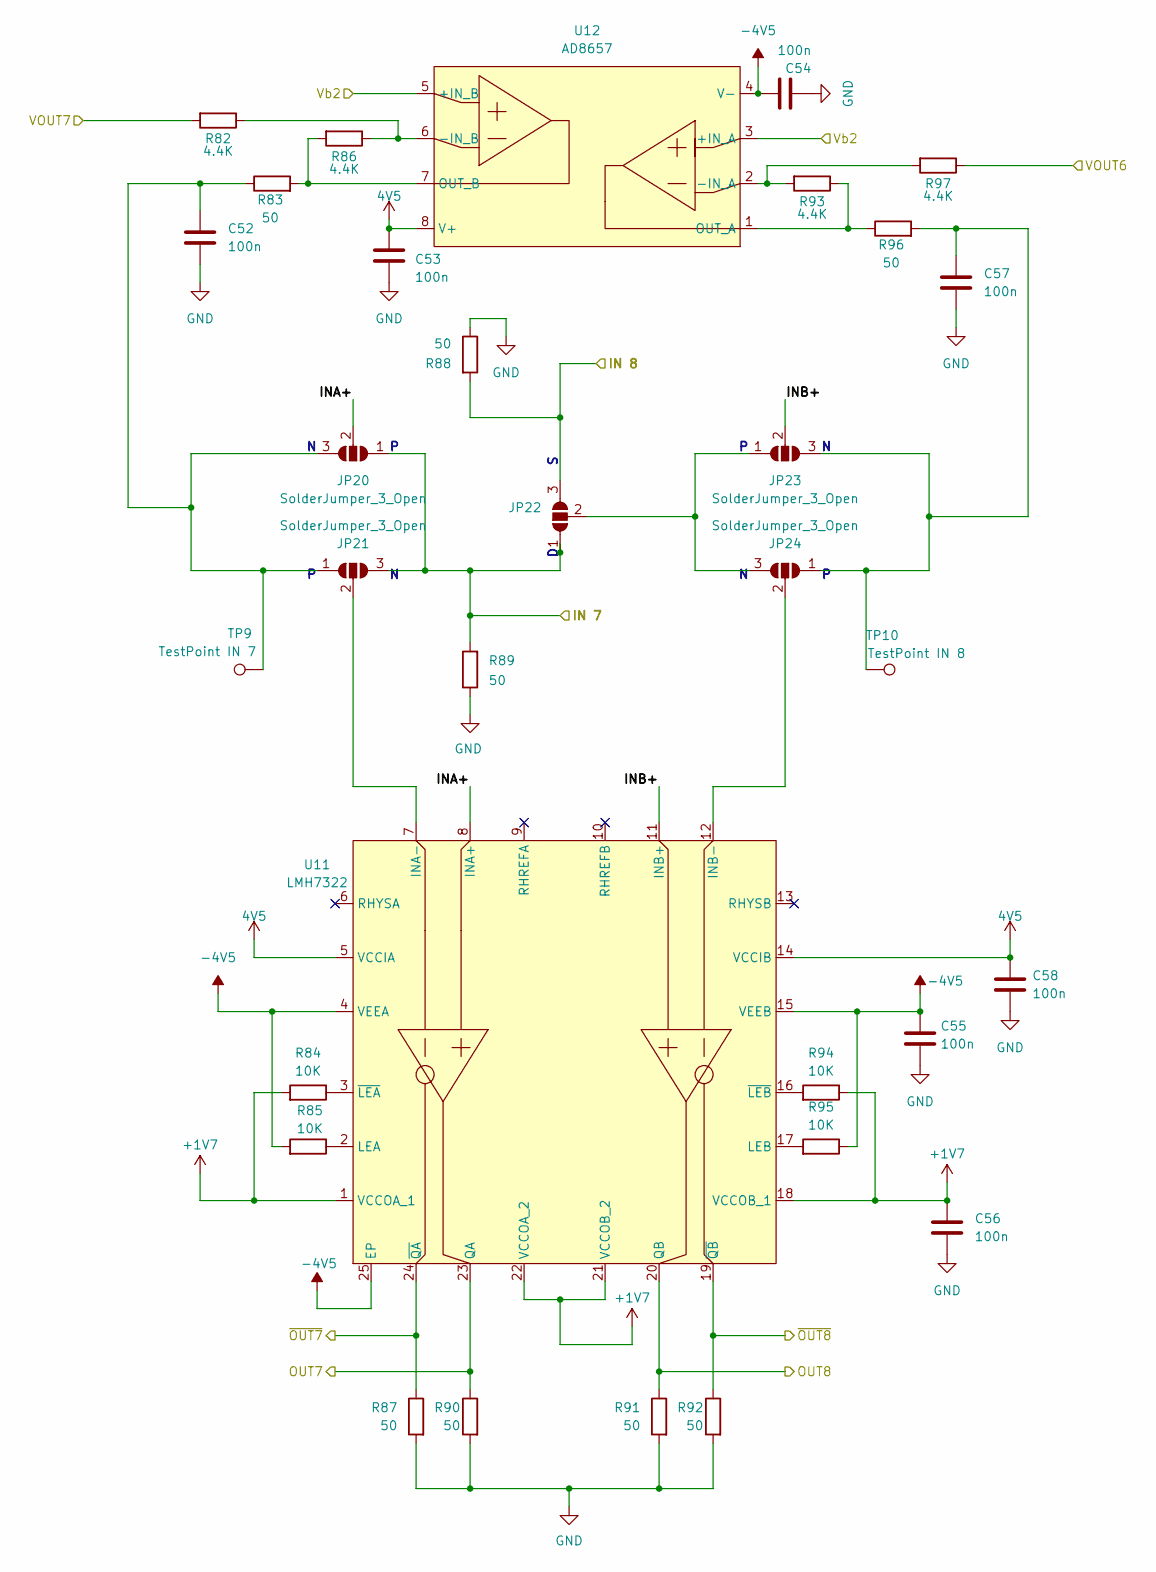
[picture p8: schematic Signals 7-8.kicad_sch]

Parts:
C52, C53, C54, C55, C56, C57, C58: 100n; C_0603_1608Metric_Pad1.08x0.95mm_HandSolder
JP20, JP21, JP22, JP23, JP24: SolderJumper_3_Open; SolderJumper-3_P1.3mm_Open_RoundedPad1.0x1.5mm_NumberLabels
R82, R86, R93, R97: 4.4K; R_0603_1608Metric_Pad0.98x0.95mm_HandSolder
R83, R87, R88, R89, R90, R91, R92, R96: 50; R_0603_1608Metric_Pad0.98x0.95mm_HandSolder
R84, R85, R94, R95: 10K; R_0603_1608Metric_Pad0.98x0.95mm_HandSolder
TP9: TestPoint IN 7; TestPoint_Pad_D1.0mm
TP10: TestPoint IN 8; TestPoint_Pad_D1.0mm
U11: LMH7322; QFN50P400X400X80-25N
U12: AD8657; SOP65P490X110-8N

Connections:
4V5: C53.1, C58.1, U11.5 (VCCIA), U11.14 (VCCIB), U12.8 (V+)
+1V7: C56.1, R84.2, R94.1, U11.1 (VCCOA_1), U11.18 (VCCOB_1), U11.21 (VCCOB_2), U11.22 (VCCOA_2)
-4V5: C54.1, C55.1, R85.2, R95.1, U11.4 (VEEA), U11.15 (VEEB), U11.25 (EP), U12.4 (V-)
GND: C52.2, C53.2, C54.2, C55.2, C56.2, C57.2, C58.2, R87.2, R88.1, R89.1, R90.2, R91.2, R92.2
IN 7: JP20.1 (A), JP21.3 (B), JP22.1 (A), R89.2
IN 8: JP22.3 (B), R88.2
INA+: JP20.2 (C), U11.8 (INA+)
INB+: JP23.2 (C), U11.11 (INB+)
unnamed: C52.1, JP20.3 (B), JP21.1 (A), R83.1, TP9.1
unnamed: C57.1, JP23.3 (B), JP24.1 (A), R96.2, TP10.1
unnamed: JP21.2 (C), U11.7 (INA-)
unnamed: JP22.2 (C), JP23.1 (A), JP24.3 (B)
unnamed: JP24.2 (C), U11.12 (INB-)
unnamed: R82.1, R86.1, U12.6 (-IN_B)
unnamed: R83.2, R86.2, U12.7 (OUT_B)
unnamed: R84.1, U11.3 (~LEA)
unnamed: R85.1, U11.2 (LEA)
unnamed: R93.1, R96.1, U12.1 (OUT_A)
unnamed: R93.2, R97.2, U12.2 (-IN_A)
unnamed: R94.2, U11.16 (~LEB)
unnamed: R95.2, U11.17 (LEB)
OUT7: R90.1, U11.23 (QA)
OUT8: R91.1, U11.20 (QB)
VOUT6: R97.1
VOUT7: R82.2
Vb2: U12.3 (+IN_A), U12.5 (+IN_B)
~OUT7: R87.1, U11.24 (~QA)
~OUT8: R92.1, U11.19 (~QB)
