alexb7396/picoCMP/Kicad picoCMP/Signals 9-10.kicad_sch

## KiCad design Kicad picoCMP/Signals 9-10.kicad_sch (2025-03-20)

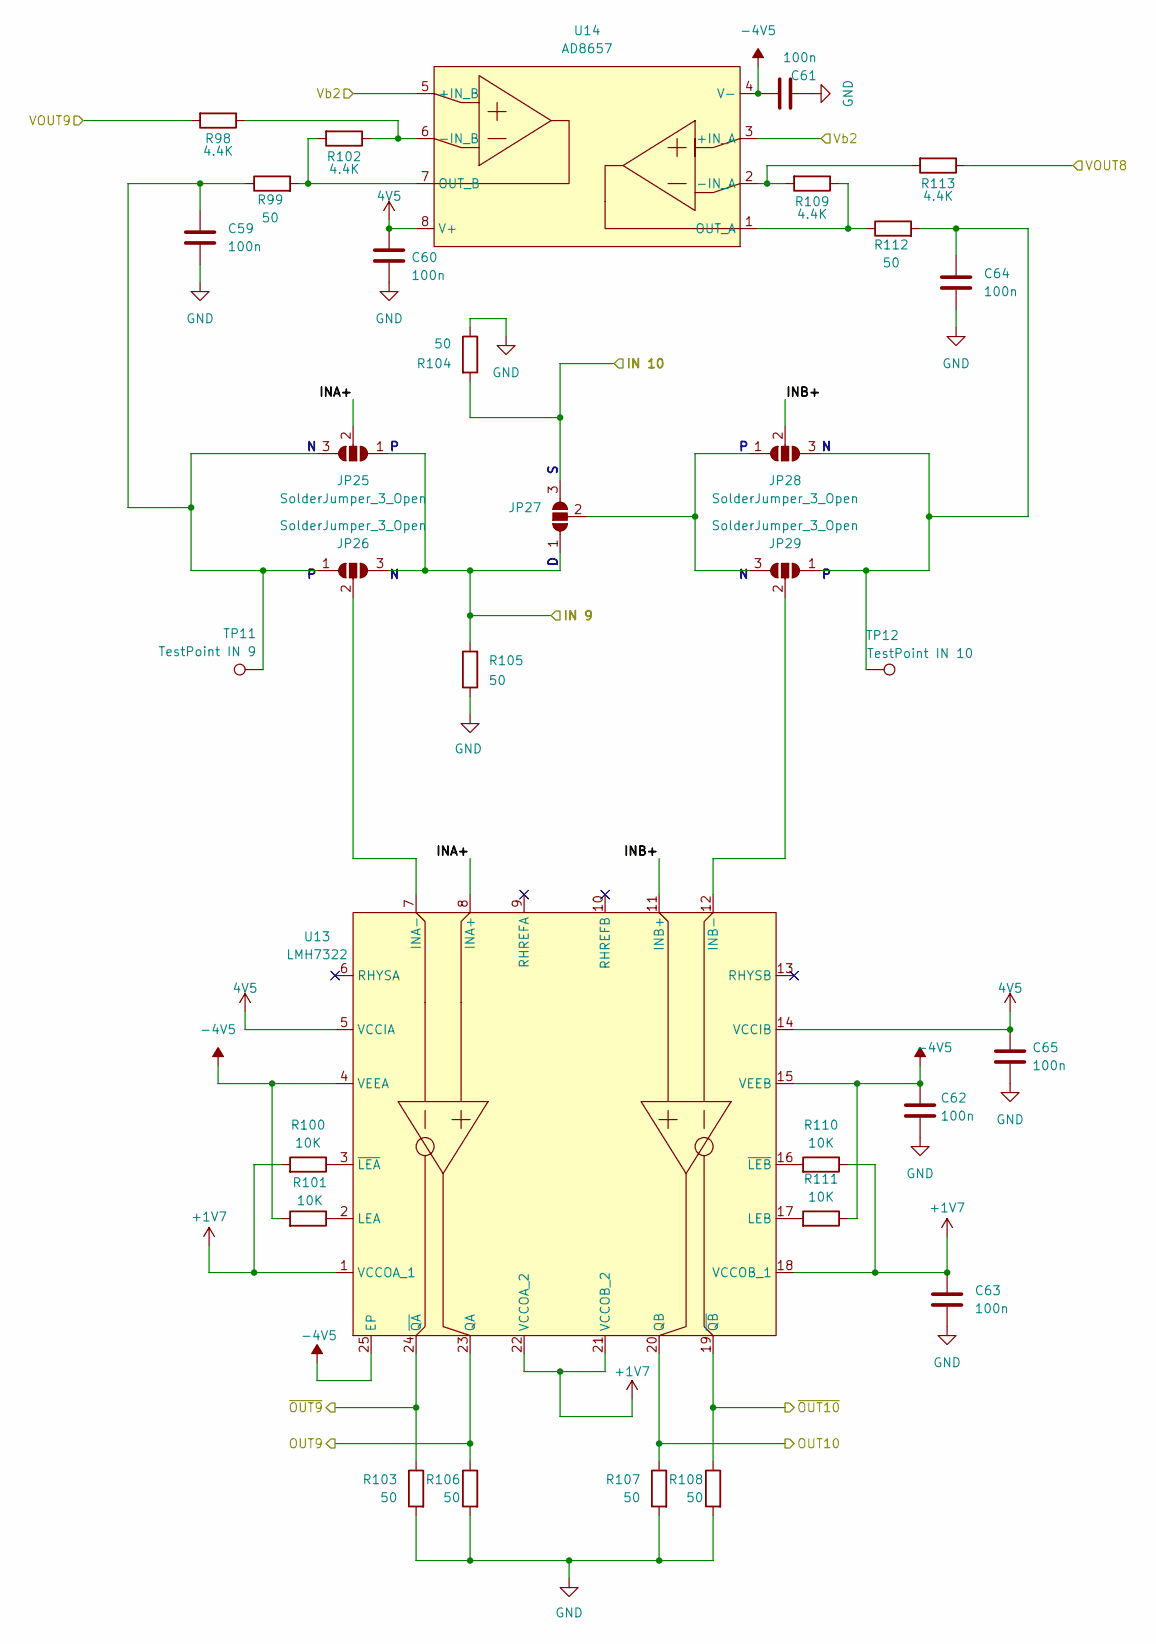
[picture p9: schematic Signals 9-10.kicad_sch]

Parts:
C59, C60, C61, C62, C63, C64, C65: 100n; C_0603_1608Metric_Pad1.08x0.95mm_HandSolder
JP25, JP26, JP27, JP28, JP29: SolderJumper_3_Open; SolderJumper-3_P1.3mm_Open_RoundedPad1.0x1.5mm_NumberLabels
R98, R102, R109, R113: 4.4K; R_0603_1608Metric_Pad0.98x0.95mm_HandSolder
R99, R103, R104, R105, R106, R107, R108, R112: 50; R_0603_1608Metric_Pad0.98x0.95mm_HandSolder
R100, R101, R110, R111: 10K; R_0603_1608Metric_Pad0.98x0.95mm_HandSolder
TP11: TestPoint IN 9; TestPoint_Pad_D1.0mm
TP12: TestPoint IN 10; TestPoint_Pad_D1.0mm
U13: LMH7322; QFN50P400X400X80-25N
U14: AD8657; SOP65P490X110-8N

Connections:
4V5: C60.1, C65.1, U13.5 (VCCIA), U13.14 (VCCIB), U14.8 (V+)
+1V7: C63.1, R100.2, R110.1, U13.1 (VCCOA_1), U13.18 (VCCOB_1), U13.21 (VCCOB_2), U13.22 (VCCOA_2)
-4V5: C61.1, C62.1, R101.2, R111.1, U13.4 (VEEA), U13.15 (VEEB), U13.25 (EP), U14.4 (V-)
GND: C59.2, C60.2, C61.2, C62.2, C63.2, C64.2, C65.2, R103.2, R104.1, R105.1, R106.2, R107.2, R108.2
IN 9: JP25.1 (A), JP26.3 (B), JP27.1 (A), R105.2
IN 10: JP27.3 (B), R104.2
INA+: JP25.2 (C), U13.8 (INA+)
INB+: JP28.2 (C), U13.11 (INB+)
unnamed: C59.1, JP25.3 (B), JP26.1 (A), R99.1, TP11.1
unnamed: C64.1, JP28.3 (B), JP29.1 (A), R112.2, TP12.1
unnamed: JP26.2 (C), U13.7 (INA-)
unnamed: JP27.2 (C), JP28.1 (A), JP29.3 (B)
unnamed: JP29.2 (C), U13.12 (INB-)
unnamed: R100.1, U13.3 (~LEA)
unnamed: R101.1, U13.2 (LEA)
unnamed: R98.1, R102.1, U14.6 (-IN_B)
unnamed: R99.2, R102.2, U14.7 (OUT_B)
unnamed: R109.1, R112.1, U14.1 (OUT_A)
unnamed: R109.2, R113.2, U14.2 (-IN_A)
unnamed: R110.2, U13.16 (~LEB)
unnamed: R111.2, U13.17 (LEB)
OUT9: R106.1, U13.23 (QA)
OUT10: R107.1, U13.20 (QB)
VOUT8: R113.1
VOUT9: R98.2
Vb2: U14.3 (+IN_A), U14.5 (+IN_B)
~OUT9: R103.1, U13.24 (~QA)
~OUT10: R108.1, U13.19 (~QB)
