alexb7396/picoCMP/Kicad picoCMP/Signals 11-12.kicad_sch

## KiCad design Kicad picoCMP/Signals 11-12.kicad_sch (2025-03-20)

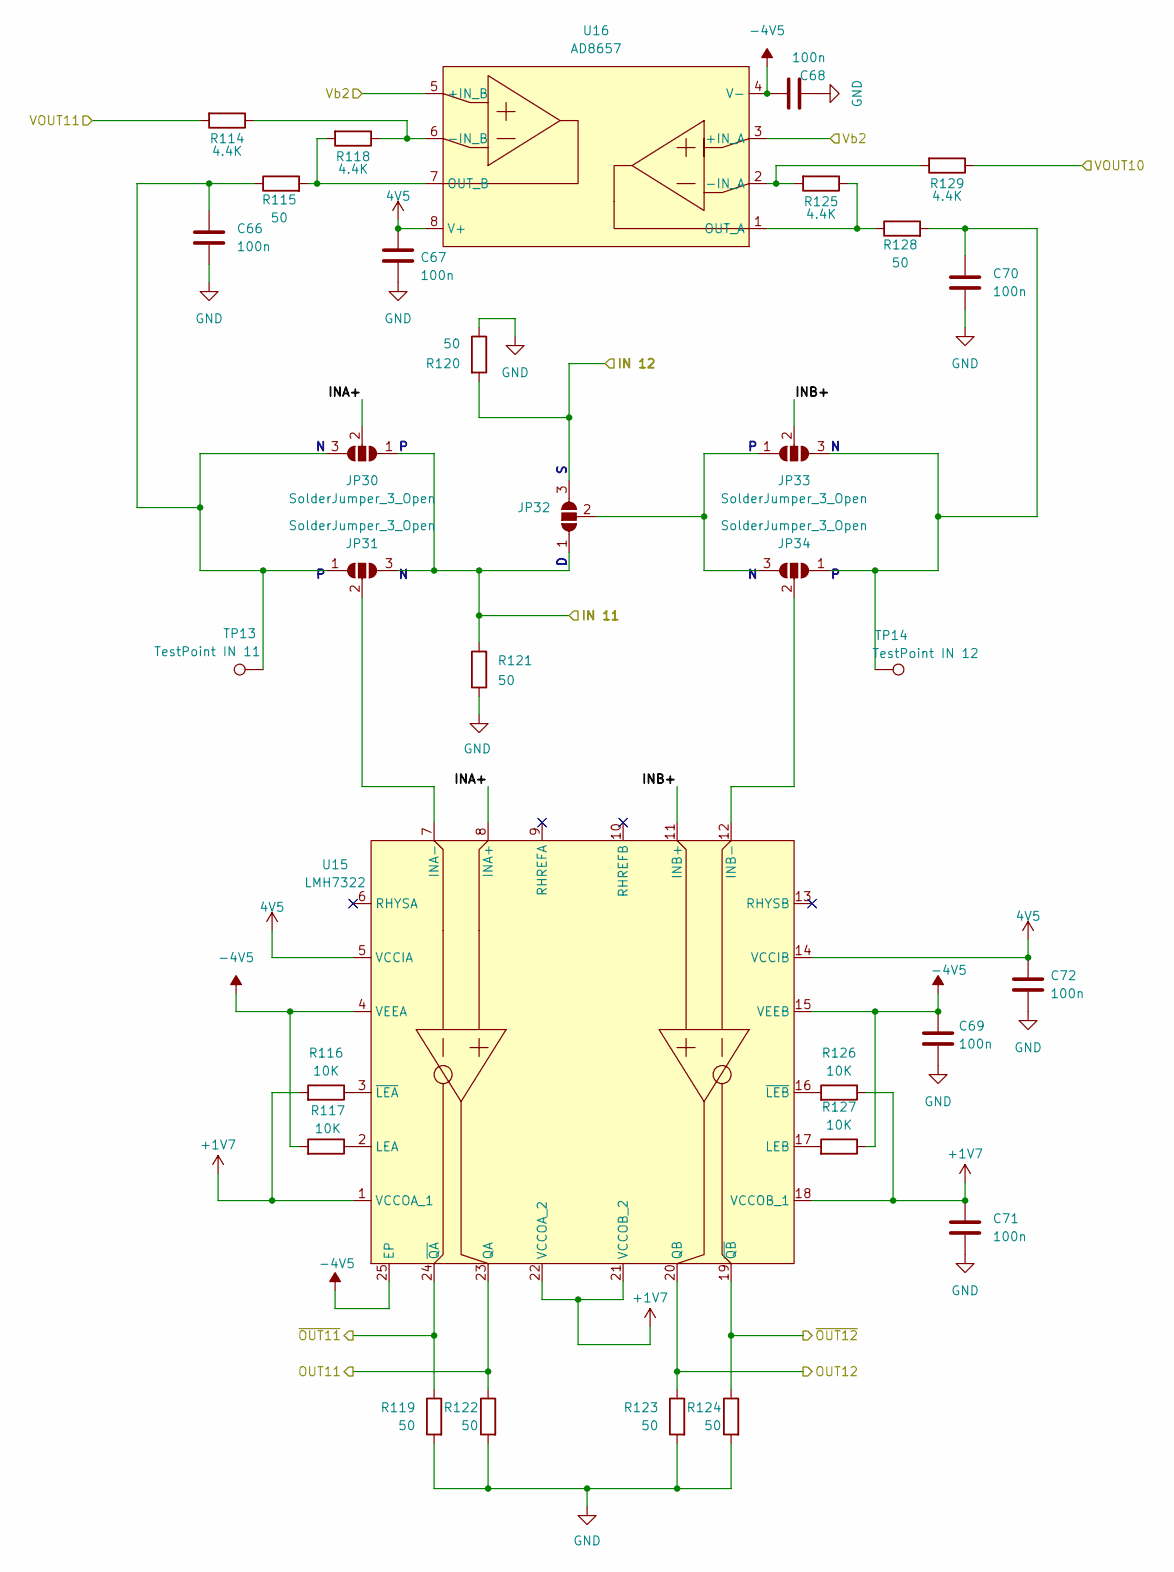
[picture p10: schematic Signals 11-12.kicad_sch]

Parts:
C66, C67, C68, C69, C70, C71, C72: 100n; C_0603_1608Metric_Pad1.08x0.95mm_HandSolder
JP30, JP31, JP32, JP33, JP34: SolderJumper_3_Open; SolderJumper-3_P1.3mm_Open_RoundedPad1.0x1.5mm_NumberLabels
R114, R118, R125, R129: 4.4K; R_0603_1608Metric_Pad0.98x0.95mm_HandSolder
R115, R119, R120, R121, R122, R123, R124, R128: 50; R_0603_1608Metric_Pad0.98x0.95mm_HandSolder
R116, R117, R126, R127: 10K; R_0603_1608Metric_Pad0.98x0.95mm_HandSolder
TP13: TestPoint IN 11; TestPoint_Pad_D1.0mm
TP14: TestPoint IN 12; TestPoint_Pad_D1.0mm
U15: LMH7322; QFN50P400X400X80-25N
U16: AD8657; SOP65P490X110-8N

Connections:
4V5: C67.1, C72.1, U15.5 (VCCIA), U15.14 (VCCIB), U16.8 (V+)
+1V7: C71.1, R116.2, R126.1, U15.1 (VCCOA_1), U15.18 (VCCOB_1), U15.21 (VCCOB_2), U15.22 (VCCOA_2)
-4V5: C68.1, C69.1, R117.2, R127.1, U15.4 (VEEA), U15.15 (VEEB), U15.25 (EP), U16.4 (V-)
GND: C66.2, C67.2, C68.2, C69.2, C70.2, C71.2, C72.2, R119.2, R120.1, R121.1, R122.2, R123.2, R124.2
IN 11: JP30.1 (A), JP31.3 (B), JP32.1 (A), R121.2
IN 12: JP32.3 (B), R120.2
INA+: JP30.2 (C), U15.8 (INA+)
INB+: JP33.2 (C), U15.11 (INB+)
unnamed: C66.1, JP30.3 (B), JP31.1 (A), R115.1, TP13.1
unnamed: C70.1, JP33.3 (B), JP34.1 (A), R128.2, TP14.1
unnamed: JP31.2 (C), U15.7 (INA-)
unnamed: JP32.2 (C), JP33.1 (A), JP34.3 (B)
unnamed: JP34.2 (C), U15.12 (INB-)
unnamed: R114.1, R118.1, U16.6 (-IN_B)
unnamed: R115.2, R118.2, U16.7 (OUT_B)
unnamed: R116.1, U15.3 (~LEA)
unnamed: R117.1, U15.2 (LEA)
unnamed: R125.1, R128.1, U16.1 (OUT_A)
unnamed: R125.2, R129.2, U16.2 (-IN_A)
unnamed: R126.2, U15.16 (~LEB)
unnamed: R127.2, U15.17 (LEB)
OUT11: R122.1, U15.23 (QA)
OUT12: R123.1, U15.20 (QB)
VOUT10: R129.1
VOUT11: R114.2
Vb2: U16.3 (+IN_A), U16.5 (+IN_B)
~OUT11: R119.1, U15.24 (~QA)
~OUT12: R124.1, U15.19 (~QB)
