alexb7396/picoCMP/Kicad picoCMP/Signals 13-14.kicad_sch

## KiCad design Kicad picoCMP/Signals 13-14.kicad_sch (2025-03-20)

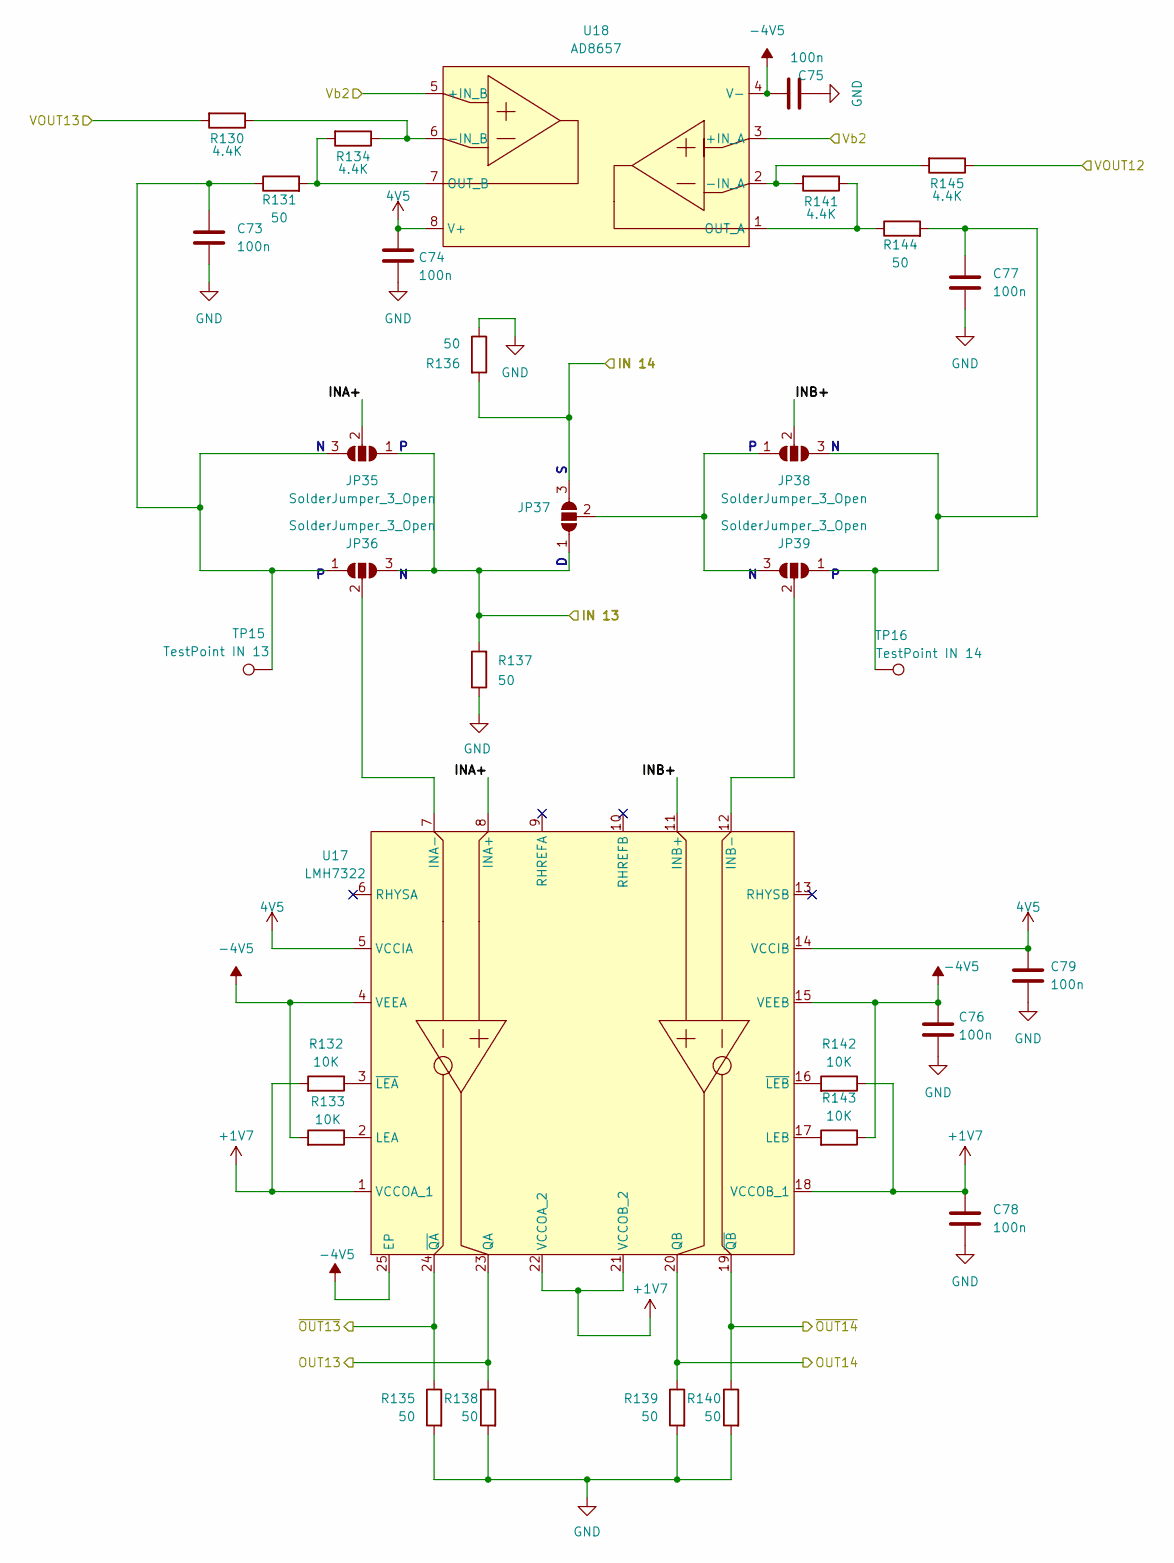
[picture p11: schematic Signals 13-14.kicad_sch]

Parts:
C73, C74, C75, C76, C77, C78, C79: 100n; C_0603_1608Metric_Pad1.08x0.95mm_HandSolder
JP35, JP36, JP37, JP38, JP39: SolderJumper_3_Open; SolderJumper-3_P1.3mm_Open_RoundedPad1.0x1.5mm_NumberLabels
R130, R134, R141, R145: 4.4K; R_0603_1608Metric_Pad0.98x0.95mm_HandSolder
R131, R135, R136, R137, R138, R139, R140, R144: 50; R_0603_1608Metric_Pad0.98x0.95mm_HandSolder
R132, R133, R142, R143: 10K; R_0603_1608Metric_Pad0.98x0.95mm_HandSolder
TP15: TestPoint IN 13; TestPoint_Pad_D1.0mm
TP16: TestPoint IN 14; TestPoint_Pad_D1.0mm
U17: LMH7322; QFN50P400X400X80-25N
U18: AD8657; SOP65P490X110-8N

Connections:
4V5: C74.1, C79.1, U17.5 (VCCIA), U17.14 (VCCIB), U18.8 (V+)
+1V7: C78.1, R132.2, R142.1, U17.1 (VCCOA_1), U17.18 (VCCOB_1), U17.21 (VCCOB_2), U17.22 (VCCOA_2)
-4V5: C75.1, C76.1, R133.2, R143.1, U17.4 (VEEA), U17.15 (VEEB), U17.25 (EP), U18.4 (V-)
GND: C73.2, C74.2, C75.2, C76.2, C77.2, C78.2, C79.2, R135.2, R136.1, R137.1, R138.2, R139.2, R140.2
IN 13: JP35.1 (A), JP36.3 (B), JP37.1 (A), R137.2
IN 14: JP37.3 (B), R136.2
INA+: JP35.2 (C), U17.8 (INA+)
INB+: JP38.2 (C), U17.11 (INB+)
unnamed: C73.1, JP35.3 (B), JP36.1 (A), R131.1, TP15.1
unnamed: C77.1, JP38.3 (B), JP39.1 (A), R144.2, TP16.1
unnamed: JP36.2 (C), U17.7 (INA-)
unnamed: JP37.2 (C), JP38.1 (A), JP39.3 (B)
unnamed: JP39.2 (C), U17.12 (INB-)
unnamed: R130.1, R134.1, U18.6 (-IN_B)
unnamed: R131.2, R134.2, U18.7 (OUT_B)
unnamed: R132.1, U17.3 (~LEA)
unnamed: R133.1, U17.2 (LEA)
unnamed: R141.1, R144.1, U18.1 (OUT_A)
unnamed: R141.2, R145.2, U18.2 (-IN_A)
unnamed: R142.2, U17.16 (~LEB)
unnamed: R143.2, U17.17 (LEB)
OUT13: R138.1, U17.23 (QA)
OUT14: R139.1, U17.20 (QB)
VOUT12: R145.1
VOUT13: R130.2
Vb2: U18.3 (+IN_A), U18.5 (+IN_B)
~OUT13: R135.1, U17.24 (~QA)
~OUT14: R140.1, U17.19 (~QB)
