alexb7396/picoCMP/Kicad picoCMP/Signals 15-16.kicad_sch

## KiCad design Kicad picoCMP/Signals 15-16.kicad_sch (2025-03-20)

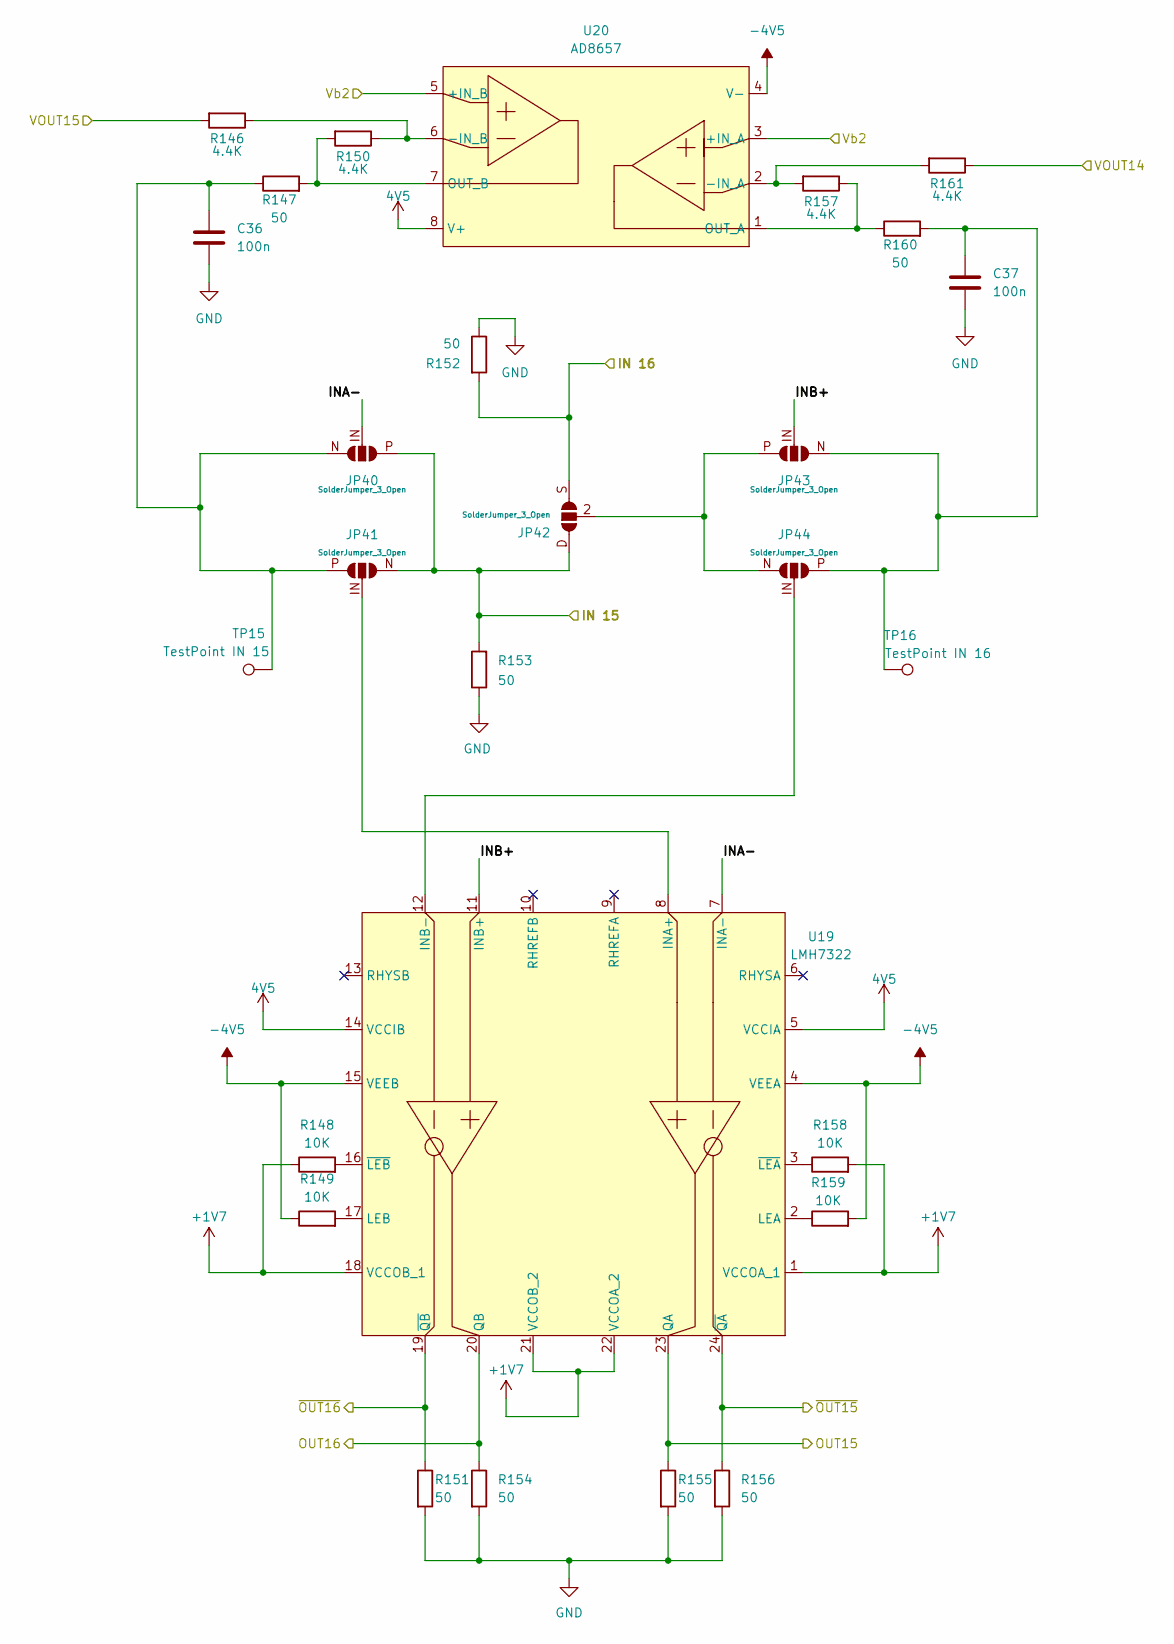
[picture p12: schematic Signals 15-16.kicad_sch]

Parts:
C36, C37: 100n
JP40, JP41, JP42, JP43, JP44: SolderJumper_3_Open
R146, R150, R157, R161: 4.4K
R147, R151, R152, R153, R154, R155, R156, R160: 50
R148, R149, R158, R159: 10K
TP15: TestPoint IN 15
TP16: TestPoint IN 16
U19: LMH7322; QFN50P400X400X80-25N
U20: AD8657; SOP65P490X110-8N

Connections:
4V5: U19.5 (VCCIA), U19.14 (VCCIB), U20.8 (V+)
+1V7: R148.1, R158.2, U19.1 (VCCOA_1), U19.18 (VCCOB_1), U19.21 (VCCOB_2), U19.22 (VCCOA_2)
-4V5: R149.1, R159.2, U19.4 (VEEA), U19.15 (VEEB), U20.4 (V-)
GND: C36.2, C37.2, R151.2, R152.1, R153.1, R154.2, R155.2, R156.2
IN 15: JP40.P (A), JP41.N (B), JP42.D (A), R153.2
IN 16: JP42.S (B), R152.2
INA-: JP40.IN (C), U19.7 (INA-)
INB+: JP43.IN (C), U19.11 (INB+)
unnamed: C36.1, JP40.N (B), JP41.P (A), R147.1, TP15.1
unnamed: C37.1, JP43.N (A), JP44.P (B), R160.2, TP16.1
unnamed: JP41.IN (C), U19.8 (INA+)
unnamed: JP42.2 (IN), JP43.P (B), JP44.N (A)
unnamed: JP44.IN (C), U19.12 (INB-)
unnamed: R146.1, R150.1, U20.6 (-IN_B)
unnamed: R147.2, R150.2, U20.7 (OUT_B)
unnamed: R148.2, U19.16 (~LEB)
unnamed: R149.2, U19.17 (LEB)
unnamed: R157.1, R160.1, U20.1 (OUT_A)
unnamed: R157.2, R161.2, U20.2 (-IN_A)
unnamed: R158.1, U19.3 (~LEA)
unnamed: R159.1, U19.2 (LEA)
OUT15: R155.1, U19.23 (QA)
OUT16: R154.1, U19.20 (QB)
VOUT14: R161.1
VOUT15: R146.2
Vb2: U20.3 (+IN_A), U20.5 (+IN_B)
~OUT15: R156.1, U19.24 (~QA)
~OUT16: R151.1, U19.19 (~QB)
