alexb7396/picoCMP/Kicad picoCMP/Trigger 0.kicad_sch

## KiCad design Kicad picoCMP/Trigger 0.kicad_sch (2025-03-20)

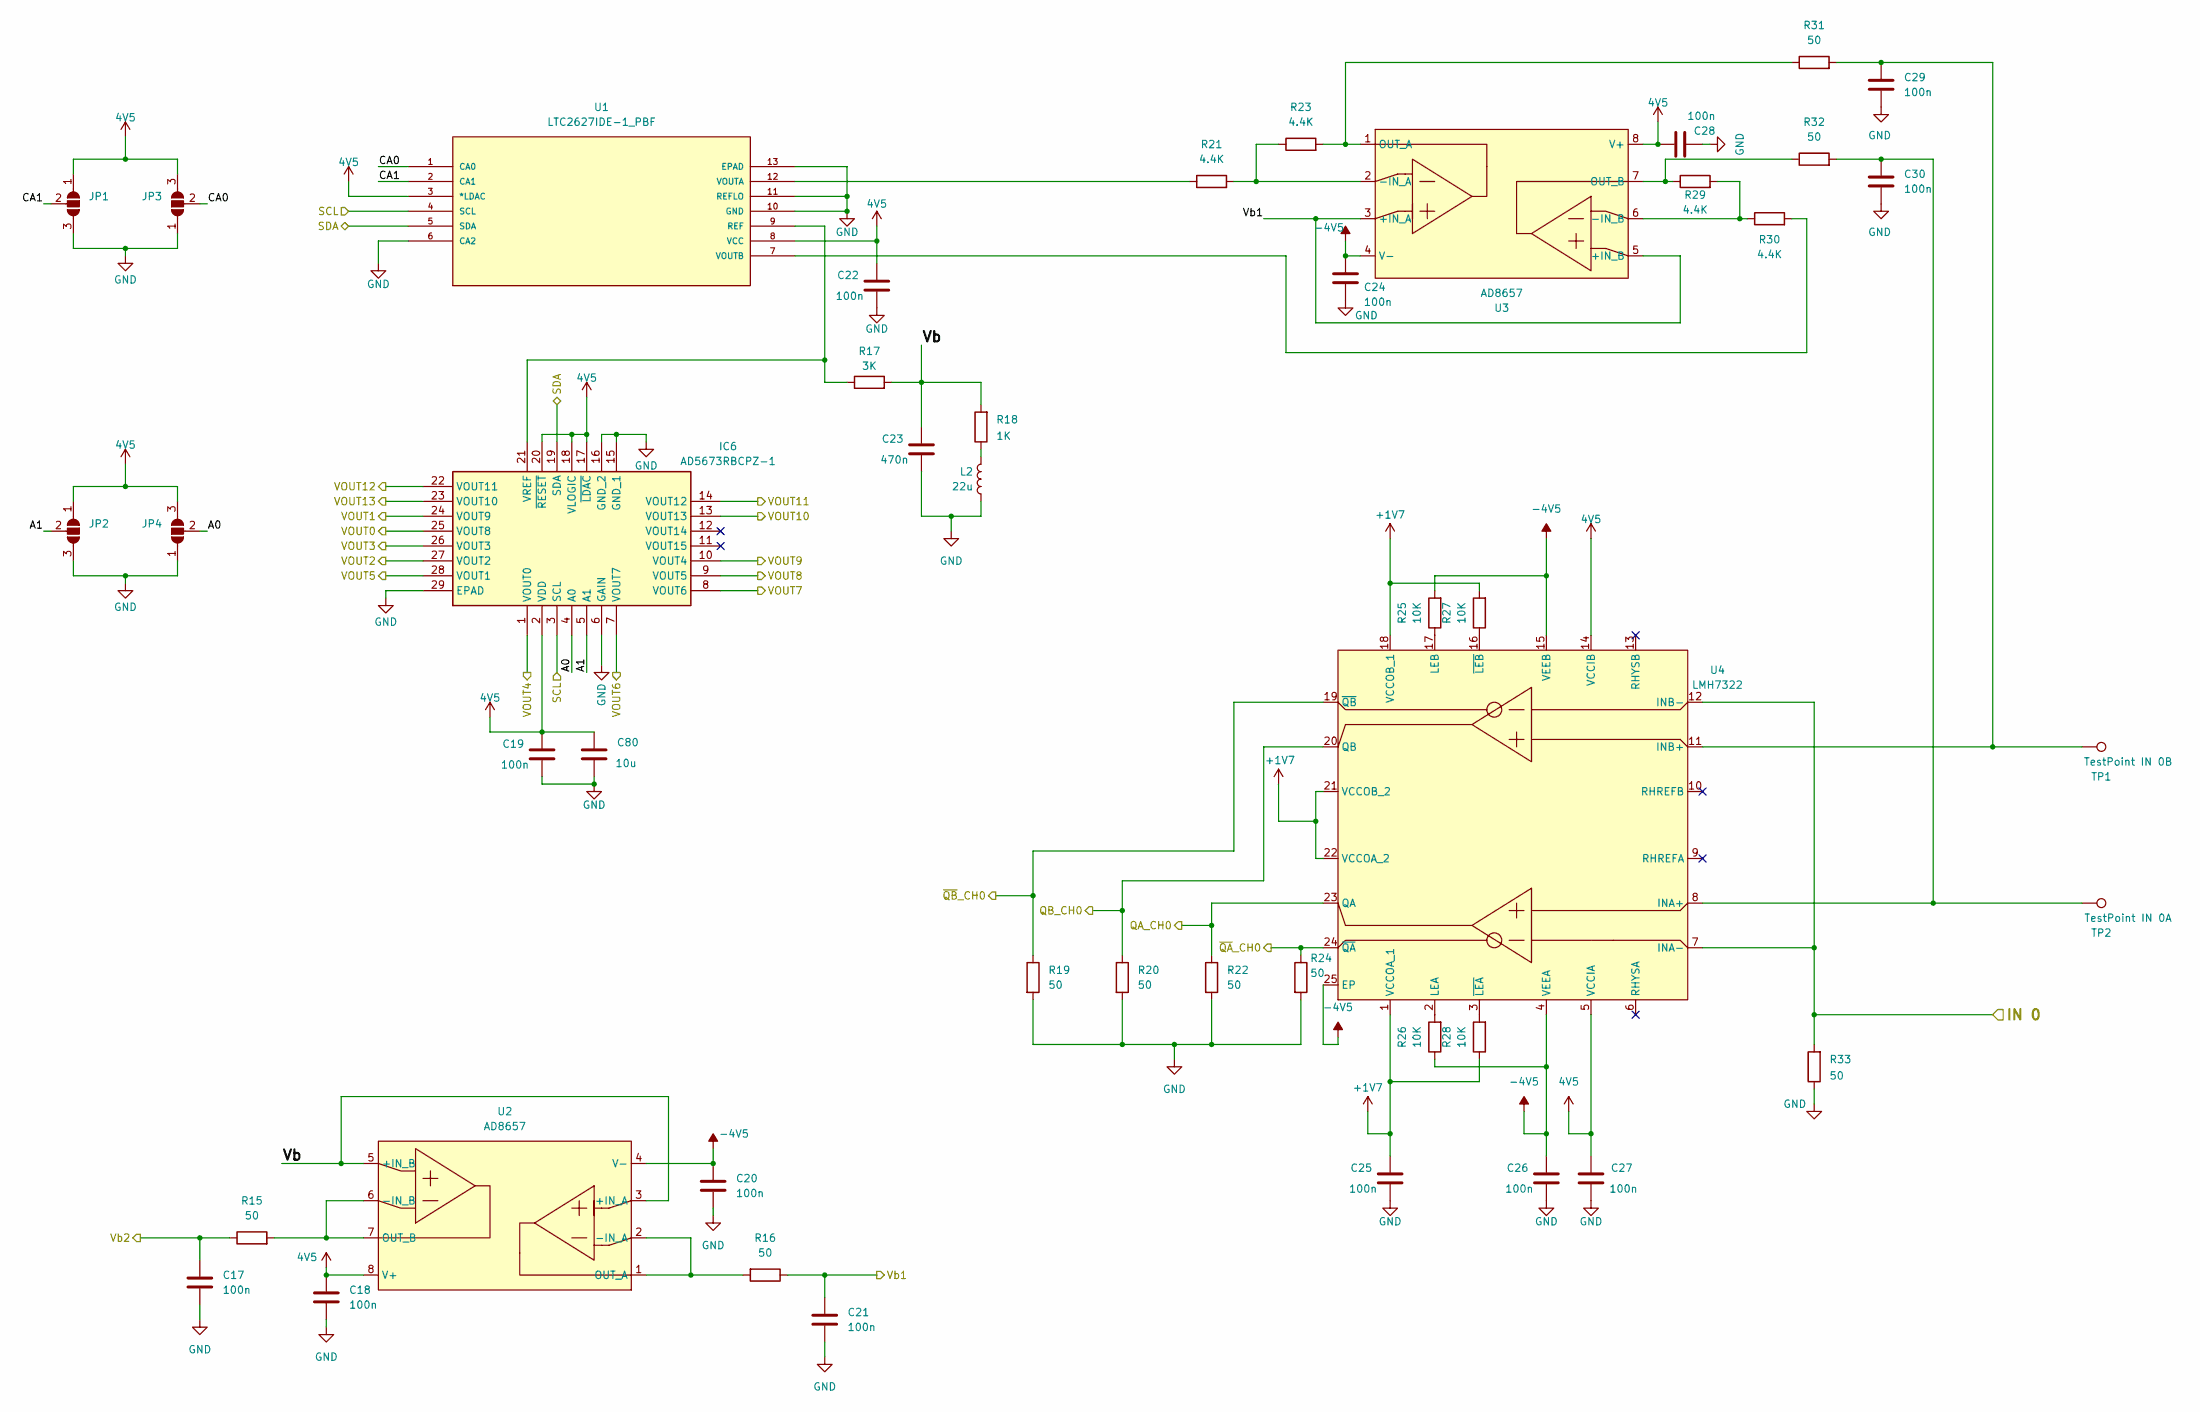
[picture p13: schematic Trigger 0.kicad_sch]

Parts:
C17, C18, C19, C20, C21, C22, C24, C25, C26, C27, C28, C29, C30: 100n; C_0603_1608Metric_Pad1.08x0.95mm_HandSolder
C23: 470n; C_0603_1608Metric_Pad1.08x0.95mm_HandSolder
C80: 10u; C_0603_1608Metric_Pad1.08x0.95mm_HandSolder
IC6: AD5673RBCPZ-1; QFN40P400X400X100-29N-D; Manufacturer_Part_Number AD5673RBCPZ-1; Mouser Part Number 584-AD5673RBCPZ-1
JP1, JP2, JP3, JP4: SolderJumper_3_Open; SolderJumper-3_P1.3mm_Open_RoundedPad1.0x1.5mm_NumberLabels
L2: 22u; L_0603_1608Metric_Pad1.05x0.95mm_HandSolder
R15, R16, R19, R20, R22, R24, R31, R32, R33: 50; R_0603_1608Metric_Pad0.98x0.95mm_HandSolder
R17: 3K; R_0603_1608Metric_Pad0.98x0.95mm_HandSolder
R18: 1K; R_0603_1608Metric_Pad0.98x0.95mm_HandSolder
R21, R23, R29, R30: 4.4K; R_0603_1608Metric_Pad0.98x0.95mm_HandSolder
R25, R26, R27, R28: 10K; R_0603_1608Metric_Pad0.98x0.95mm_HandSolder
TP1: TestPoint IN 0B; TestPoint_Pad_D1.0mm
TP2: TestPoint IN 0A; TestPoint_Pad_D1.0mm
U1: LTC2627IDE-1_PBF; DFN-12_DE; MANUFACTURER_PART_NUMBER ltc2627ide1
U2, U3: AD8657; SOP65P490X110-8N
U4: LMH7322; QFN50P400X400X80-25N

Connections:
4V5: C18.1, C19.1, C22.1, C27.1, C28.1, C80.1, IC6.2 (VDD), IC6.17 (~LDAC), IC6.18 (VLOGIC), IC6.20 (~RESET), JP1.1 (A), JP2.1 (A), JP3.3 (B), JP4.3 (B), U1.3 (*LDAC), U1.8 (VCC), U2.8 (V+), U3.8 (V+), U4.5 (VCCIA), U4.14 (VCCIB)
+1V7: C25.1, R27.2, R28.1, U4.1 (VCCOA_1), U4.18 (VCCOB_1), U4.21 (VCCOB_2), U4.22 (VCCOA_2)
-4V5: C20.1, C24.1, C26.1, R25.2, R26.1, U2.4 (V-), U3.4 (V-), U4.4 (VEEA), U4.15 (VEEB), U4.25 (EP)
A0: IC6.4 (A0), JP4.2 (C)
A1: IC6.5 (A1), JP2.2 (C)
CA0: JP3.2 (C), U1.1 (CA0)
CA1: JP1.2 (C), U1.2 (CA1)
GND: C17.2, C18.2, C19.2, C20.2, C21.2, C22.2, C23.2, C24.2, C25.2, C26.2, C27.2, C28.2, C29.2, C30.2, C80.2, IC6.6 (GAIN), IC6.15 (GND_1), IC6.16 (GND_2), IC6.29 (EPAD), JP1.3 (B), JP2.3 (B), JP3.1 (A), JP4.1 (A), L2.2, R19.2, R20.2, R22.2, R24.2, R33.1, U1.6 (CA2), U1.10 (GND), U1.11 (REFLO), U1.13 (EPAD)
IN 0: R33.2, U4.7 (INA-), U4.12 (INB-)
unnamed: C29.1, R31.2, TP1.1, U4.11 (INB+)
unnamed: C30.1, R32.2, TP2.1, U4.8 (INA+)
unnamed: IC6.21 (VREF), R17.1, U1.9 (REF)
unnamed: L2.1, R18.1
unnamed: R15.2, U2.6 (-IN_B), U2.7 (OUT_B)
unnamed: R16.2, U2.1 (OUT_A), U2.2 (-IN_A)
unnamed: R21.1, U1.12 (VOUTA)
unnamed: R21.2, R23.1, U3.2 (-IN_A)
unnamed: R23.2, R31.1, U3.1 (OUT_A)
unnamed: R25.1, U4.17 (LEB)
unnamed: R26.2, U4.2 (LEA)
unnamed: R27.1, U4.16 (~LEB)
unnamed: R28.2, U4.3 (~LEA)
unnamed: R29.1, R32.1, U3.7 (OUT_B)
unnamed: R29.2, R30.1, U3.6 (-IN_B)
unnamed: R30.2, U1.7 (VOUTB)
QA_CH0: R22.1, U4.23 (QA)
QB_CH0: R20.1, U4.20 (QB)
SCL: IC6.3 (SCL), U1.4 (SCL)
SDA: IC6.19 (SDA), U1.5 (SDA)
VOUT0: IC6.25 (VOUT8)
VOUT1: IC6.24 (VOUT9)
VOUT2: IC6.27 (VOUT2)
VOUT3: IC6.26 (VOUT3)
VOUT4: IC6.1 (VOUT0)
VOUT5: IC6.28 (VOUT1)
VOUT6: IC6.7 (VOUT7)
VOUT7: IC6.8 (VOUT6)
VOUT8: IC6.9 (VOUT5)
VOUT9: IC6.10 (VOUT4)
VOUT10: IC6.13 (VOUT13)
VOUT11: IC6.14 (VOUT12)
VOUT12: IC6.22 (VOUT11)
VOUT13: IC6.23 (VOUT10)
Vb: C23.1, R17.2, R18.2, U2.3 (+IN_A), U2.5 (+IN_B)
Vb1: C21.1, R16.1, U3.3 (+IN_A), U3.5 (+IN_B)
Vb2: C17.1, R15.1
~QA_CH0: R24.1, U4.24 (~QA)
~QB_CH0: R19.1, U4.19 (~QB)
